Emiyasama/200kHz-/技术报告/8.10/加法器f.jpg

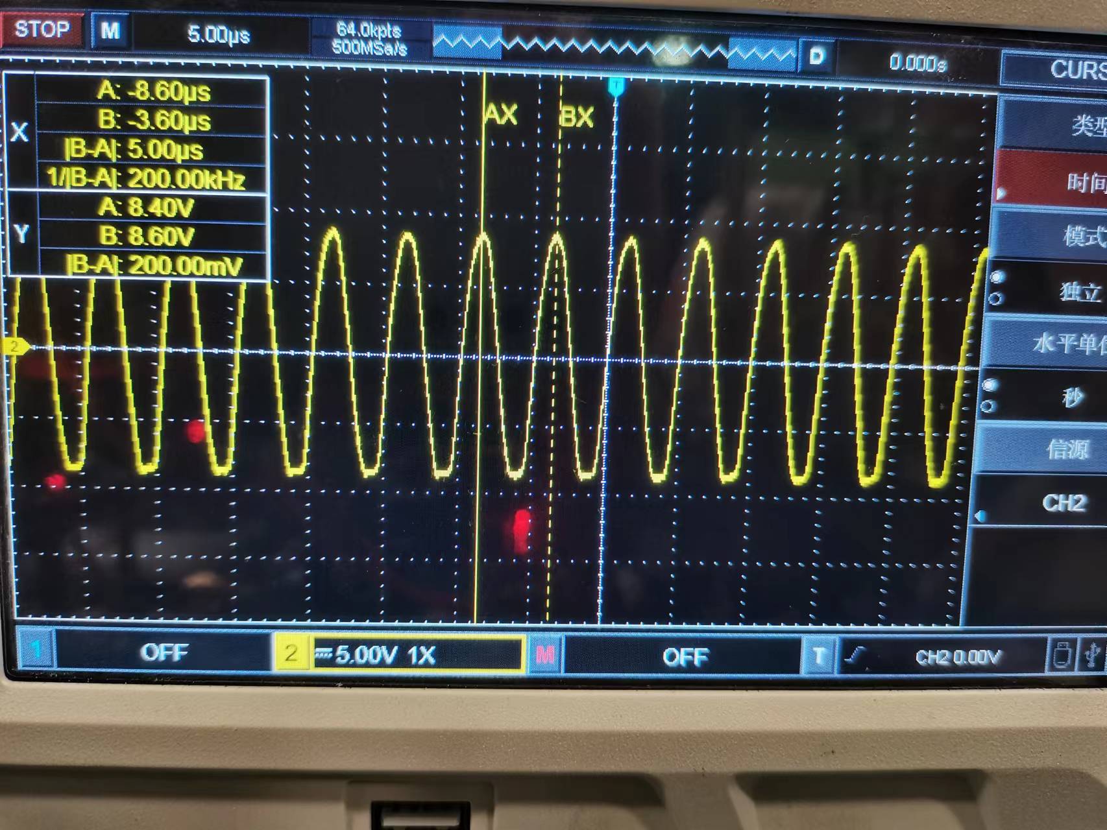
技术报告/8.10/加法器f.jpg
