Emiyasama/200kHz-/技术报告/8.10/JS放大v.jpg

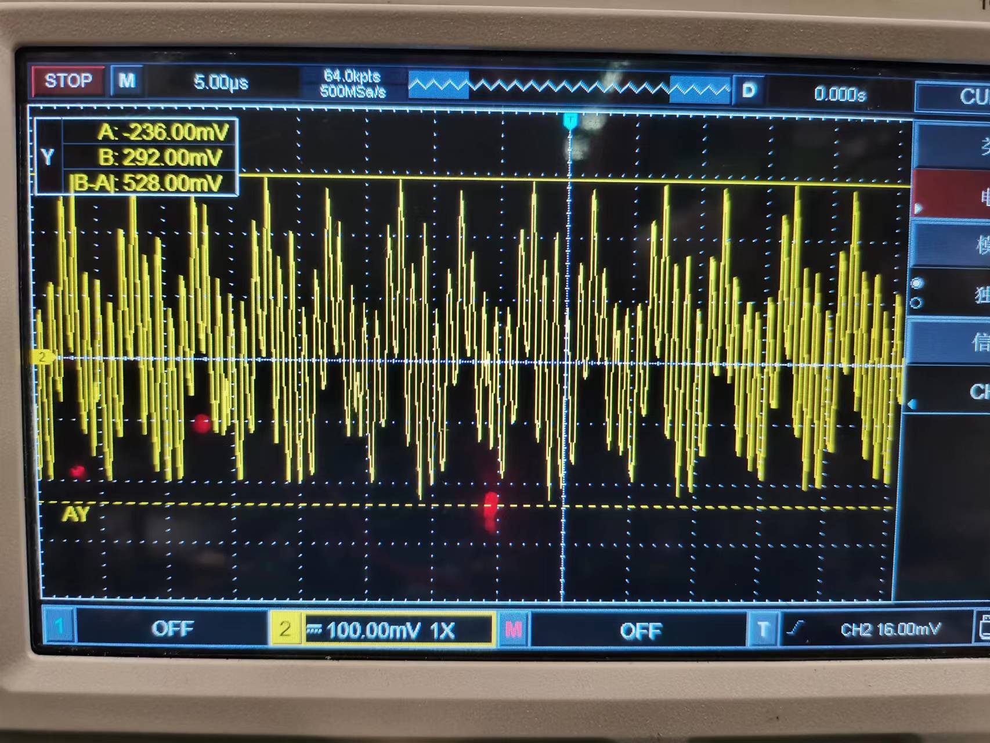
技术报告/8.10/JS放大v.jpg
