Emiyasama/200kHz-/完善部分/10.31实验测试.docx

# 10.31测试实验结果

1. 实验1

测试方法：2.8V直流手动开关

代码特点：增加GetCounter函数获取us级数据

测试结果：

测试结果分析：与手动计时大致相同

2. 实验2（1Hz）

测试方法：信号发生器不断发出1Hz方波

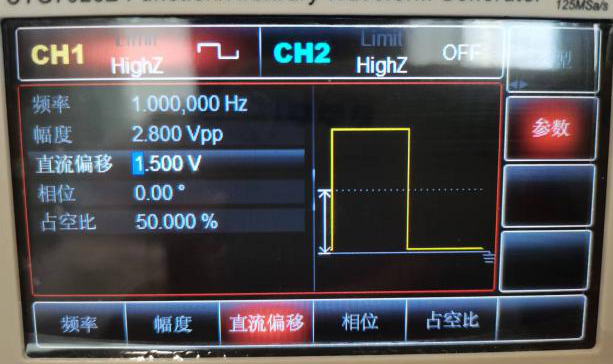
[picture p3: figure]
32578637da7344c97ca8820ba17ff3f
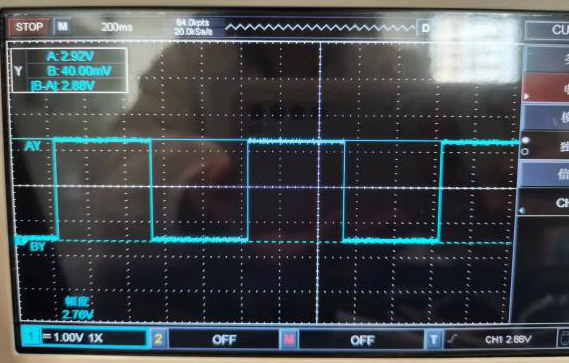
[picture p4: figure]
1dd68488990da3d1c9e9ab65cb5fa3e
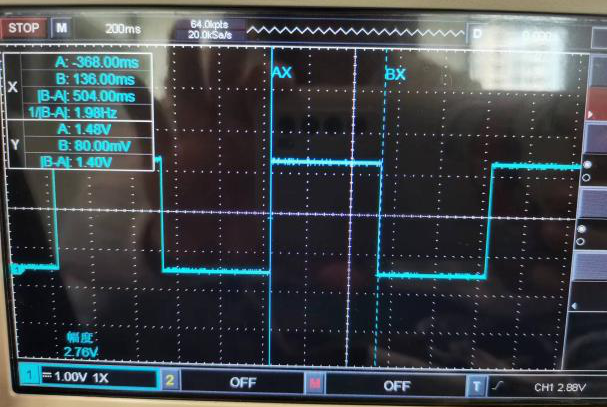
[picture p5: figure]
8cda7e7544e4407cf8b8d661fe90658

代码特点：不断检测波形为0的时间，直到检测第10次时延时暂停

测试结果：

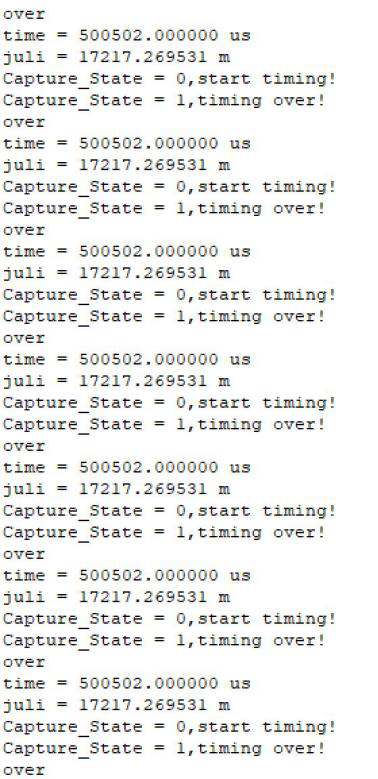
[picture p6: figure]
00c343ae68958e423938fa86a53dc3d
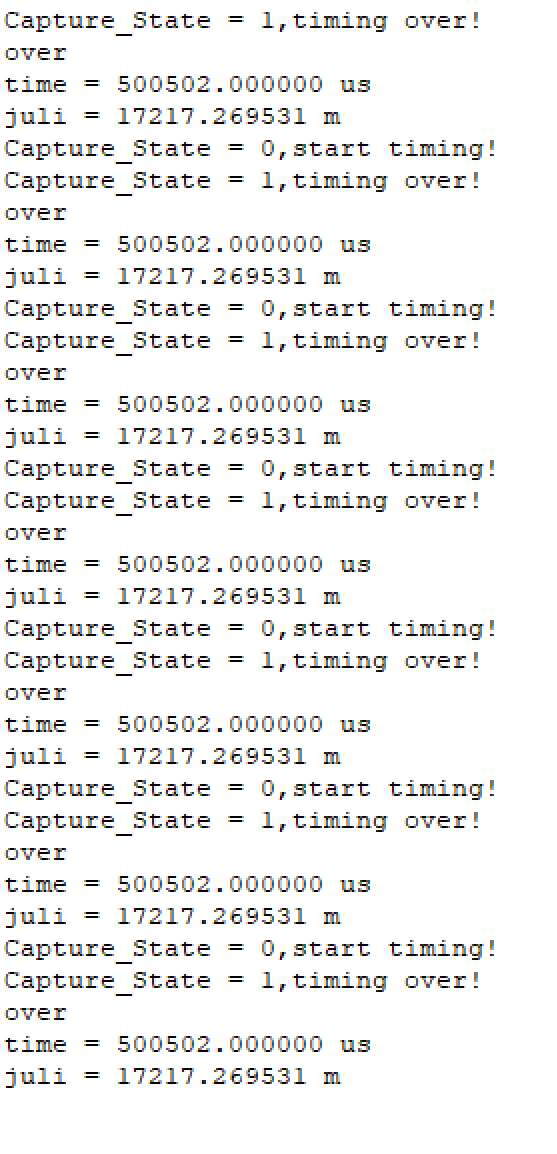
[picture p7: figure]
1231c2f782df83324b783fa7b925e0d

测试结果分析：

1Hz的波形测试结果准确，稳定为500.502ms，与示波器上显示的504ms有0.69%的误差

3. 实验3（10Hz）

测试方法：信号发生器不断发出10Hz方波

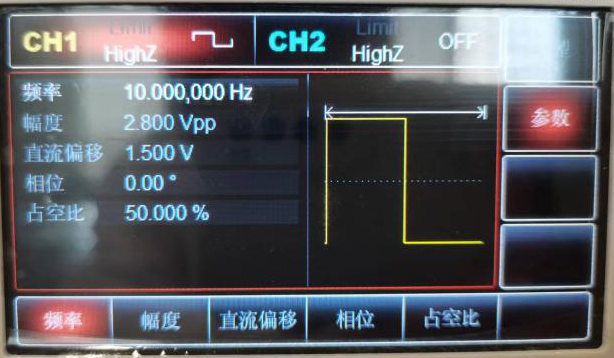
[picture p8: figure]
1635f2afd88267f08e8846b957ed129
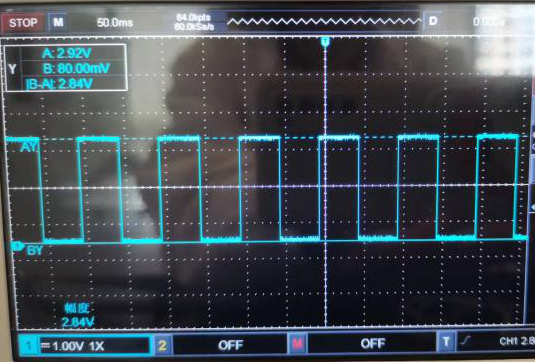
[picture p9: figure]
8b969923ffdeed18d06381cf51c97d7
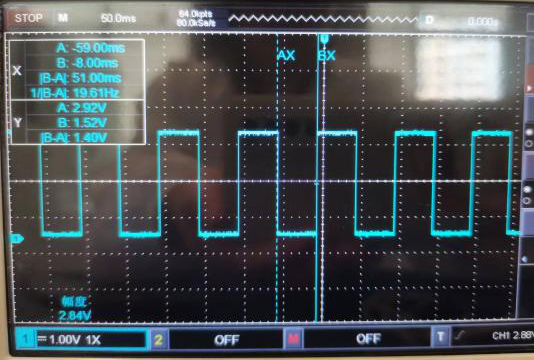
[picture p10: figure]
e0428f3fee62b50919884133da4d956

实验结果：

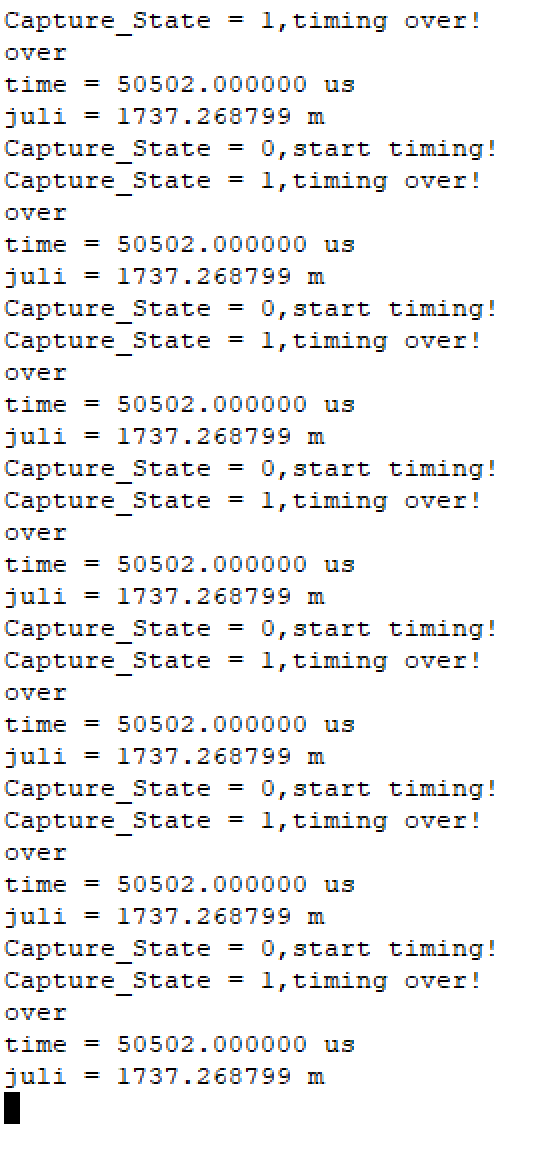
[picture p11: figure]
77cf63bb3595bb47136b22cc5ac2fc1

测试结果分析：测试结果稳定为50.502ms，与示波器上显示的51ms有0.97%的误差

4. 实验4（100Hz）

测试方法：信号发生器不断发出100Hz方波

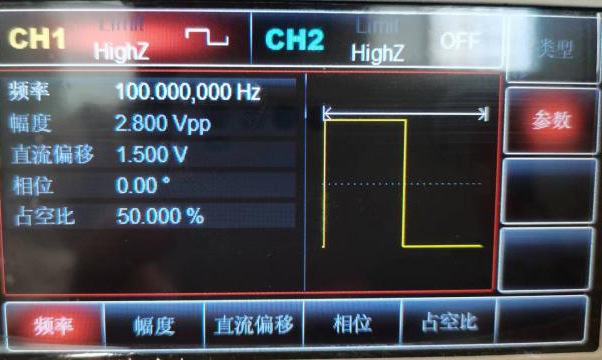
[picture p12: figure]
452ad50e35d795fb2d8274076c7eec2
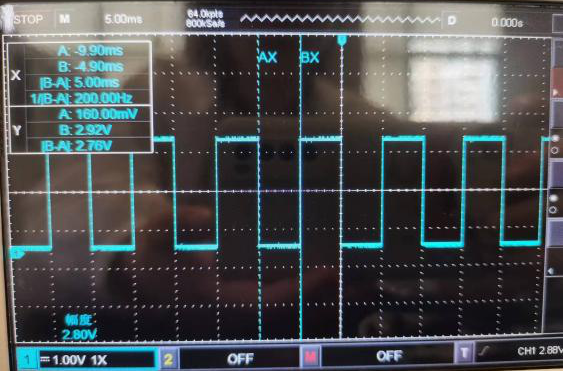
[picture p13: figure]
063b8be402b87d163d0b99ce19dfff6
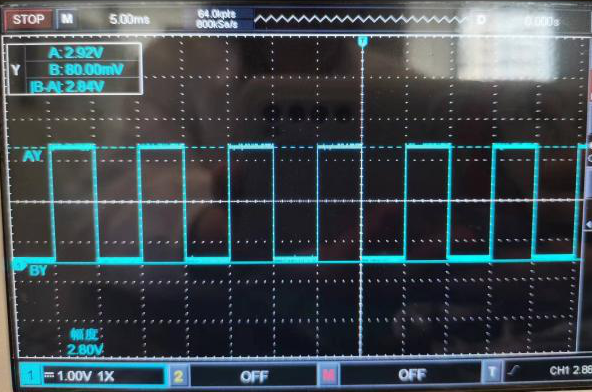
[picture p14: figure]
591af0bae8a63a09fa8aa62738394e4

实验结果：

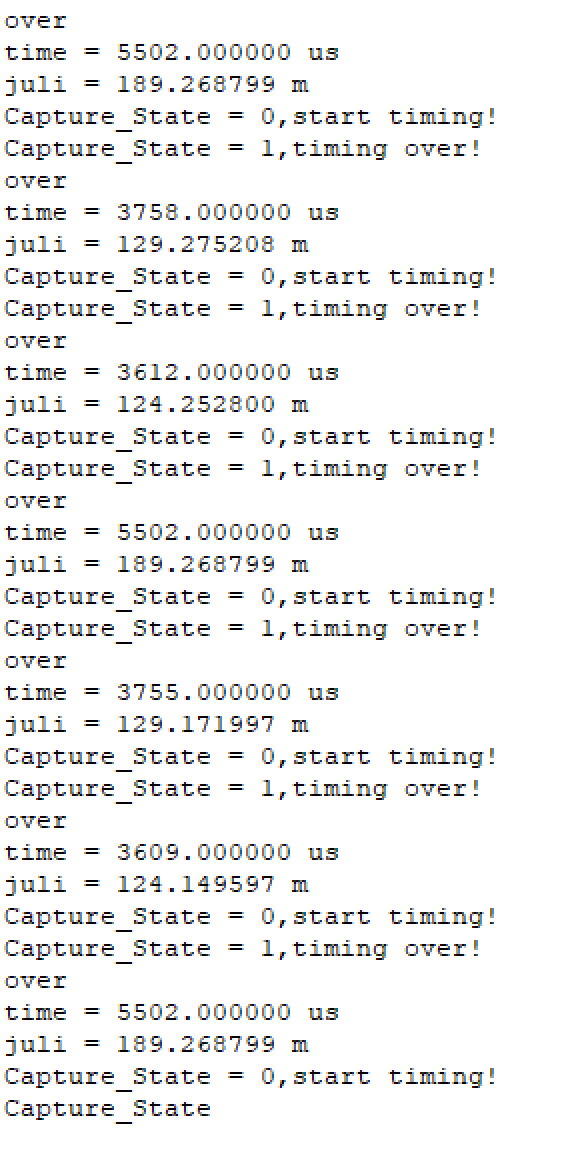
[picture p15: figure]
d63ea6d4f35196f89819aff3fc671ed

实验结果分析：100Hz时程序的运行速度就已经会影响到测量精度
