Emiyasama/200kHz-/技术报告/超声波测距测评展示.pptx

硬件

主控
STM32F103C8T6

软件

DDS发射波模块发波
&定时器开始计时

功放电路与加法器结合放大电压

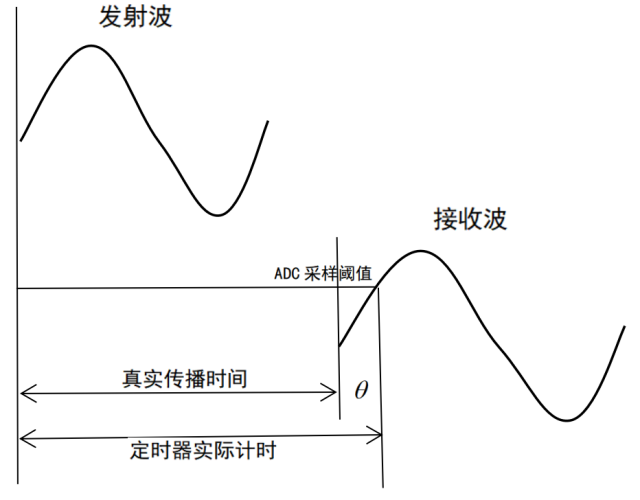
[picture p16: figure]
e5b2a22f83c2827bc41e58ca62ace3d

超声波换能器
发射端

超声波换能器接收端

功放电路放大约100倍

定时器停止计时&
fft算法计算相位差与传播时间

计算距离&关闭dds延时等待

ADC采样波形

OLED屏幕显示结果
