Emiyasama/200kHz-/完善部分/最小系统pcb板缺少元件.docx

# 新pcb板缺少元件汇总

编号 | 型号 | 类型名字 | 图片 | 数量 | 购买链接

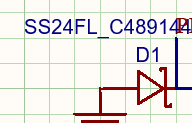
[picture p46: figure]

D1# | SS24FL_C489144 | 肖特基二极管 | | 1 | SS24肖特基二极管_SS24肖特基二极管采购信息-立创电子元器件商城 (szlcsc.com) (https://so.szlcsc.com/global.html?hot-key=LM358DR2G)

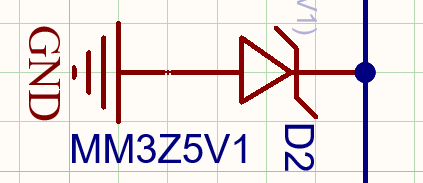
[picture p47: figure]

D2# | MM3Z5V1 | 稳压二极管 | | 1 | MM3Z5V1_MM3Z5V1采购信息-立创电子元器件商城 (szlcsc.com) (https://so.szlcsc.com/global.html?k=MM3Z5V1&hot-key=LM358DR2G)

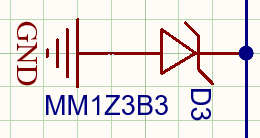
[picture p48: figure]

D3# | MM1Z3B3 | 稳压二极管 | | 1 | MM1Z3B3_MM1Z3B3采购信息-立创电子元器件商城 (szlcsc.com) (https://so.szlcsc.com/global.html?k=MM1Z3B3&hot-key=LM358DR2G)

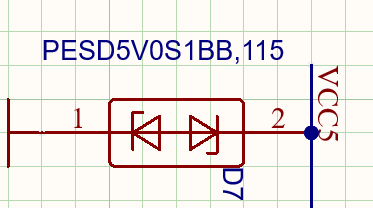
[picture p49: figure]

D7# | PESD5V0S1BB,115 | ESD保护二极管 | | 1 | PESD5V0S1BB,115_（Nexperia(安世)）PESD5V0S1BB,115中文资料_价格_PDF手册-立创电子商城 (szlcsc.com) (https://item.szlcsc.com/98848.html)

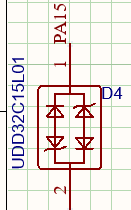
[picture p50: figure]

D4-D6,D8-D31,D33-D40# | UDD32C15L01 | ESD保护二极管 | | 35 | UDD32C05L01_（Brightking(君耀电子)）UDD32C05L01中文资料_价格_PDF手册-立创电子商城 (szlcsc.com) (https://item.szlcsc.com/79575.html)

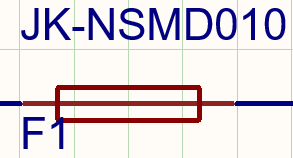
[picture p51: figure]

F1# | JK-NSMD010 | 保险电阻 | | 1 | JK-NSMD010_JK-NSMD010采购信息-立创电子元器件商城 (szlcsc.com) (https://so.szlcsc.com/global.html?k=JK-NSMD010&hot-key=LM358DR2G)

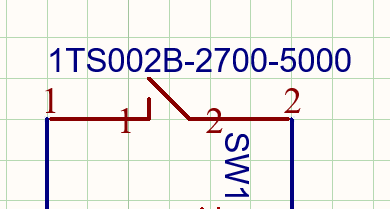
[picture p52: figure]

SW1# | 1TS002B-2700-5000 | 开关 | | 1 | 1TS002B-2700-5000-CT_（HYP(鸿源精密)）1TS002B-2700-5000-CT中文资料_价格_PDF手册-立创电子商城 (szlcsc.com) (https://item.szlcsc.com/300326.html)

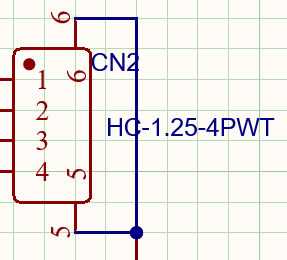
[picture p53: figure]

CN2# | HC-1.25-4PWT | 板对线连接器 | | 1 | HC-1.25-4PWT_（HCTL(华灿天禄)）HC-1.25-4PWT中文资料_价格_PDF手册-立创电子商城 (szlcsc.com) (https://item.szlcsc.com/3039062.html)
# | LM75A | 温度传感器
