Emiyasama/200kHz-/技术报告/2022年广东省大学生电子设计竞赛原创性声明(1)(1).docx

2022年广东省大学生电子设计竞赛

设计报告原创性声明

本人郑重声明：所呈交的设计报告是本人在指导老师的指导下独立进行研究/开发所取得的研究成果。除了报告中特别加以标注引用的内容外，本报告不包含任何其他个人或集体已经发表或撰写的作品成果。对本报告的研究做出重要贡献的个人和集体，均已在报告中以明确方式标明。本人完全意识到本声明的法律结果由本人承担。

作者签名：____________________________ 日期：______________
