Emiyasama/200kHz-/技术报告/2022年广东省大学生电子设计竞赛设计报告密封纸(1).docx

涂胶水区

涂胶水区

涂胶水区

[·订书针·]…………………设计报告密封纸1…………………[·订书针·]…………………设计报告密封纸1………………[·订书针·]
