Emiyasama/200kHz-/技术报告/设计报告书写规则.docx

书稿书写规则

第1篇 （一号黑体，单独占行，居中书写）

【一级标题】第1章 （单独占行，居中书写，小二号，幼圆加粗）

【示例】 A 题 双向 DC-DC 变换器

【二级标题】1.1 *** 或者 一、****（单独占行，退二字书写，小三 ，楷体）

【示例】一、任务

【三级标题】1.1.1 *** 或者（一）**** （单独占行，四号，黑体）

【四级标题】1.**** （单独占行，退二字书写，小四号 ，黑体）

【五级标题】（1）***。 （不独占行，退二字书写，五号字，宋体，后面加句号）

【六级标题】①******。 （不独占行，退二字书写，五号字，宋体，后面加句号）

作 品（黑体 三号，居中）

摘 要 （标宋 ，三号 居中）

说明：

正文： 全书五号宋体。

表：表头(黑体，小五号居中) ；表中文字 （宋体，小五号）

图： 图题 ，图注(宋体，小五号)，图中文字（宋体小五号，全书统一）。

表题、图题格式如下：表 章名-图序号， 图 章名-图序号

【示例】 表1-1 ****， 图1-1 *****。
