Emiyasama/200kHz-/赛题要求/关于2022年广东省大学生电子设计竞赛报名的通知.pdf

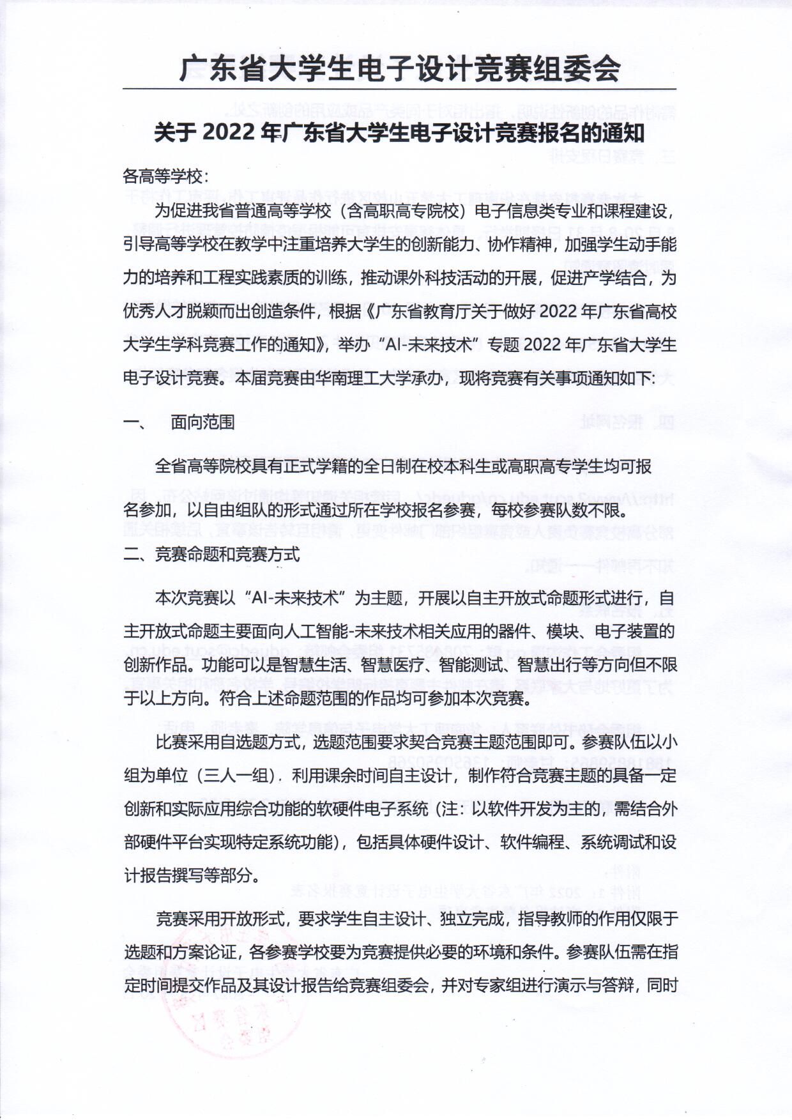
[picture p79: page 1]
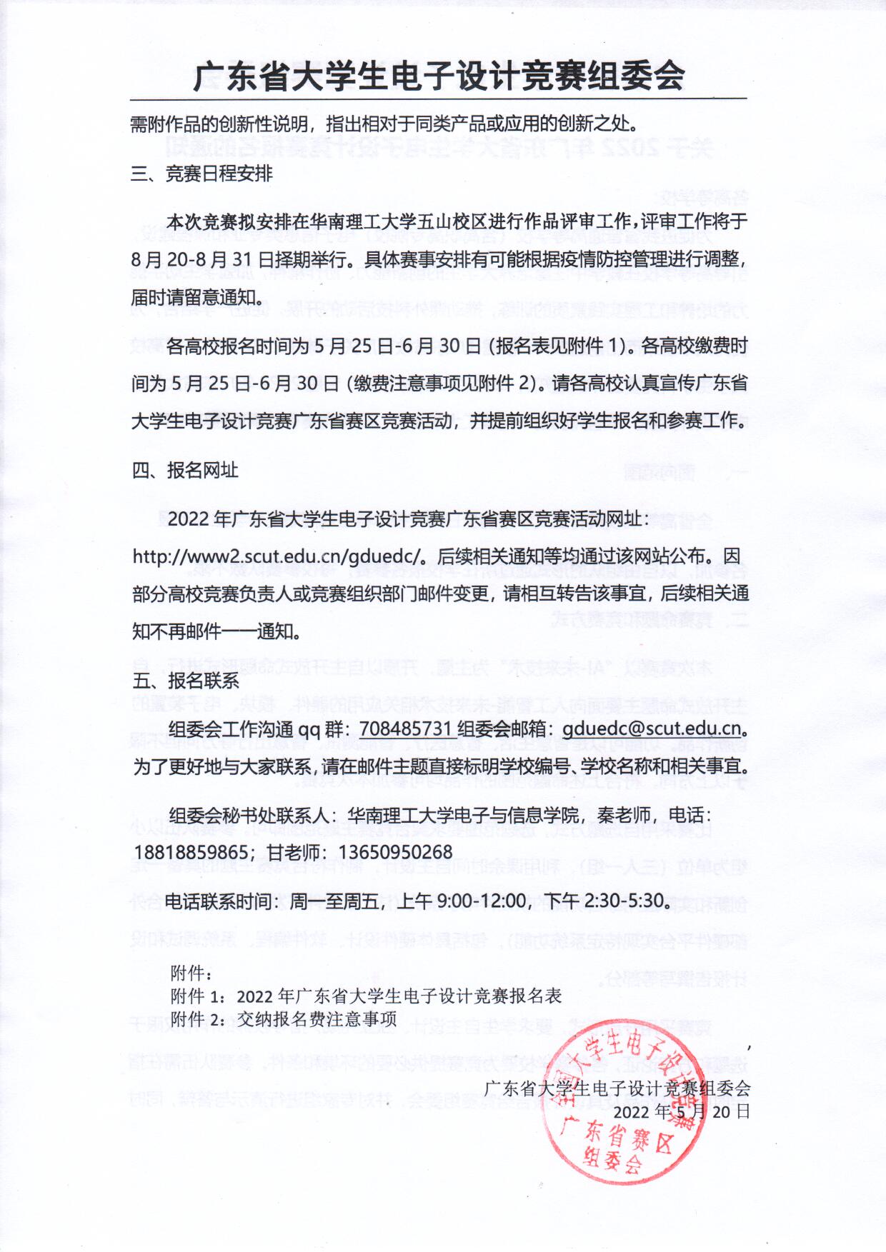
[picture p80: page 2]
