Emiyasama/200kHz-/11月22最新方案系统设计图.jpg

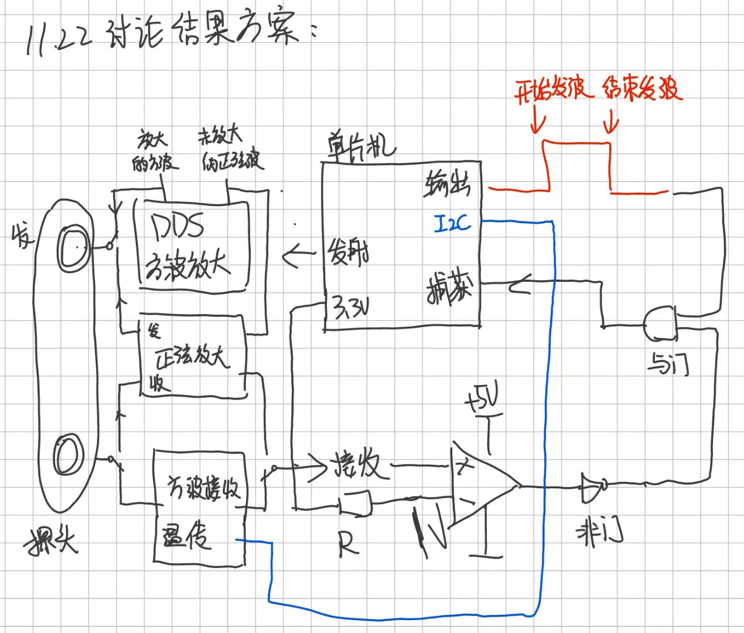
11月22最新方案系统设计图.jpg
