Emiyasama/200kHz-/参考文献/MC1496解调电路图.png

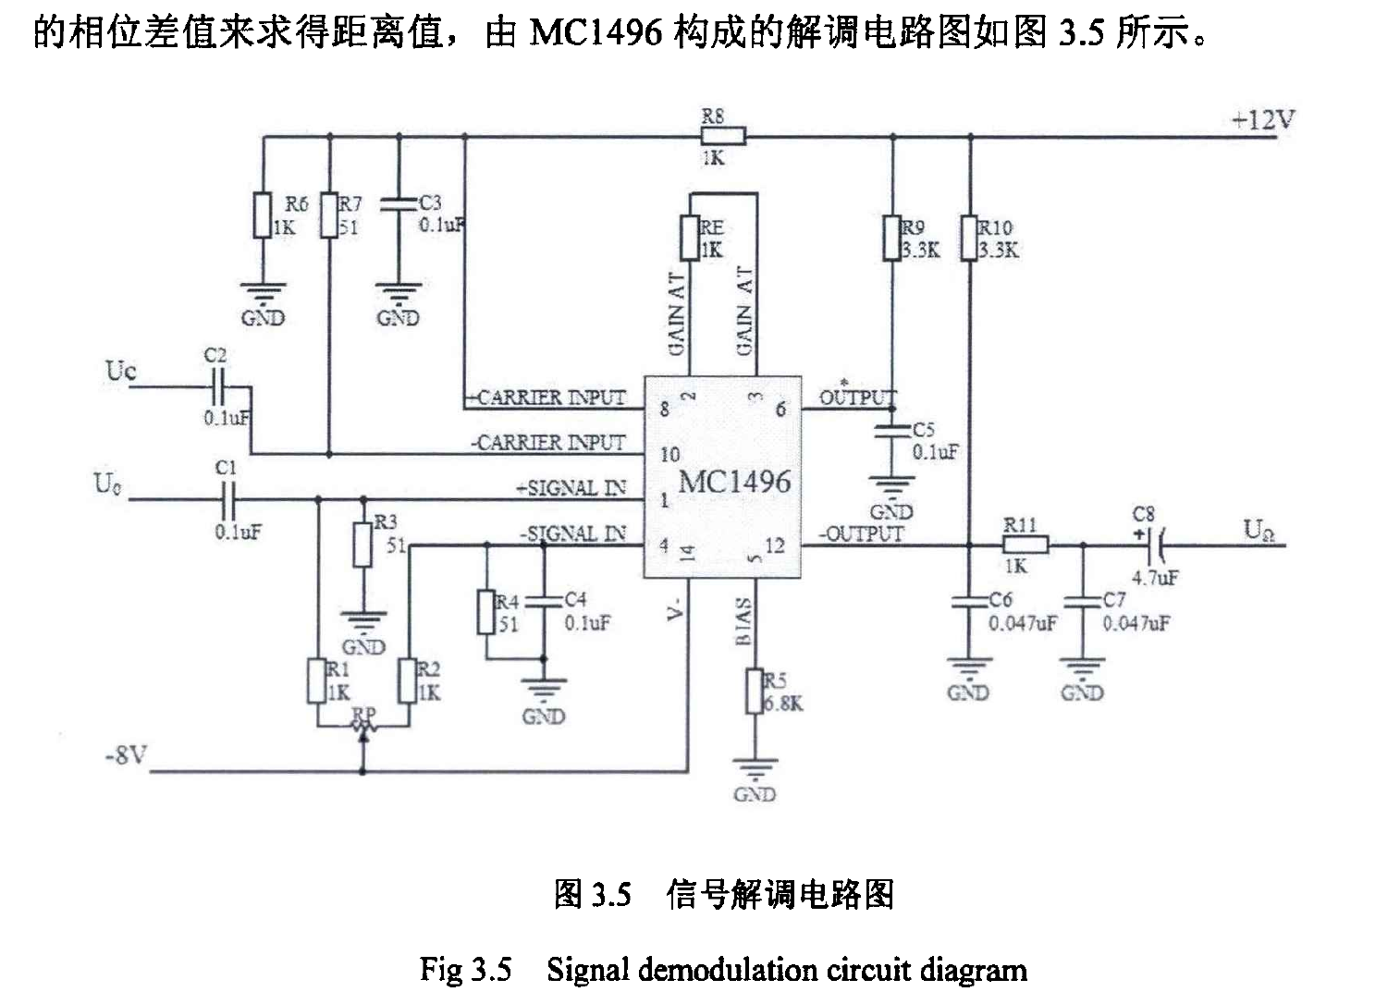
参考文献/MC1496解调电路图.png
