Emiyasama/200kHz-/参考文献/MC1496调幅电路.png

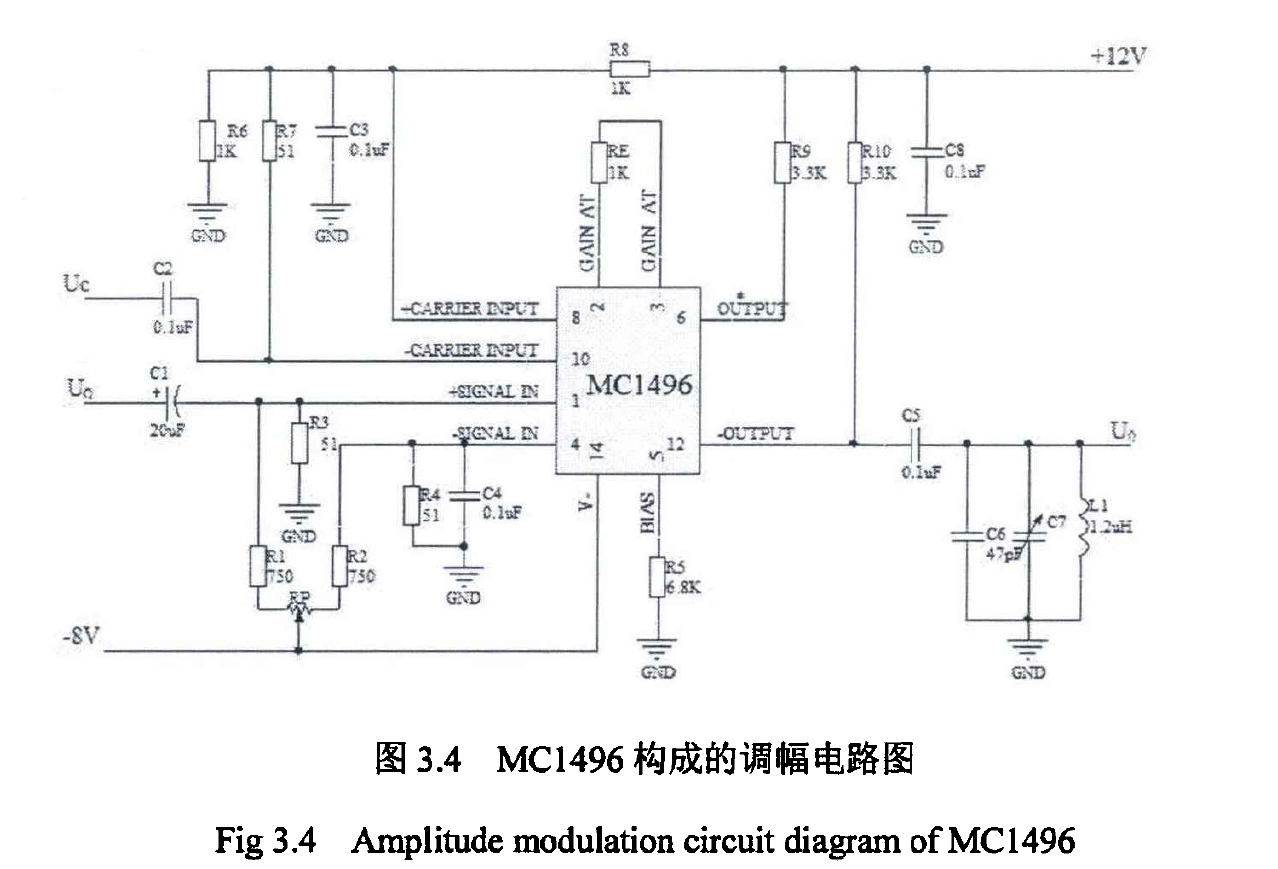
参考文献/MC1496调幅电路.png
