Emiyasama/200kHz-/参考文献/超声波发射电路.jpg

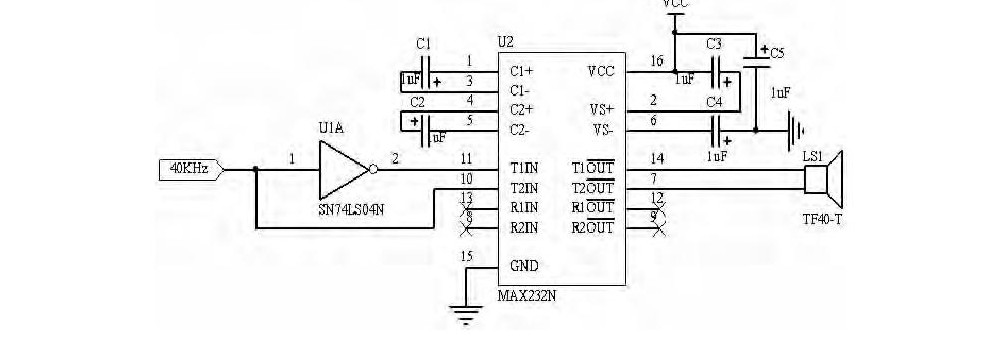
参考文献/超声波发射电路.jpg
