Emiyasama/200kHz-/参考文献/超声波接收电路.jpg

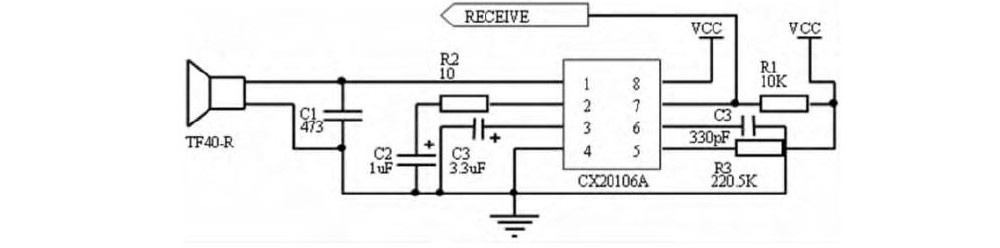
参考文献/超声波接收电路.jpg
