Emiyasama/200kHz-/参考文献/集成模拟乘法器MC1496.png

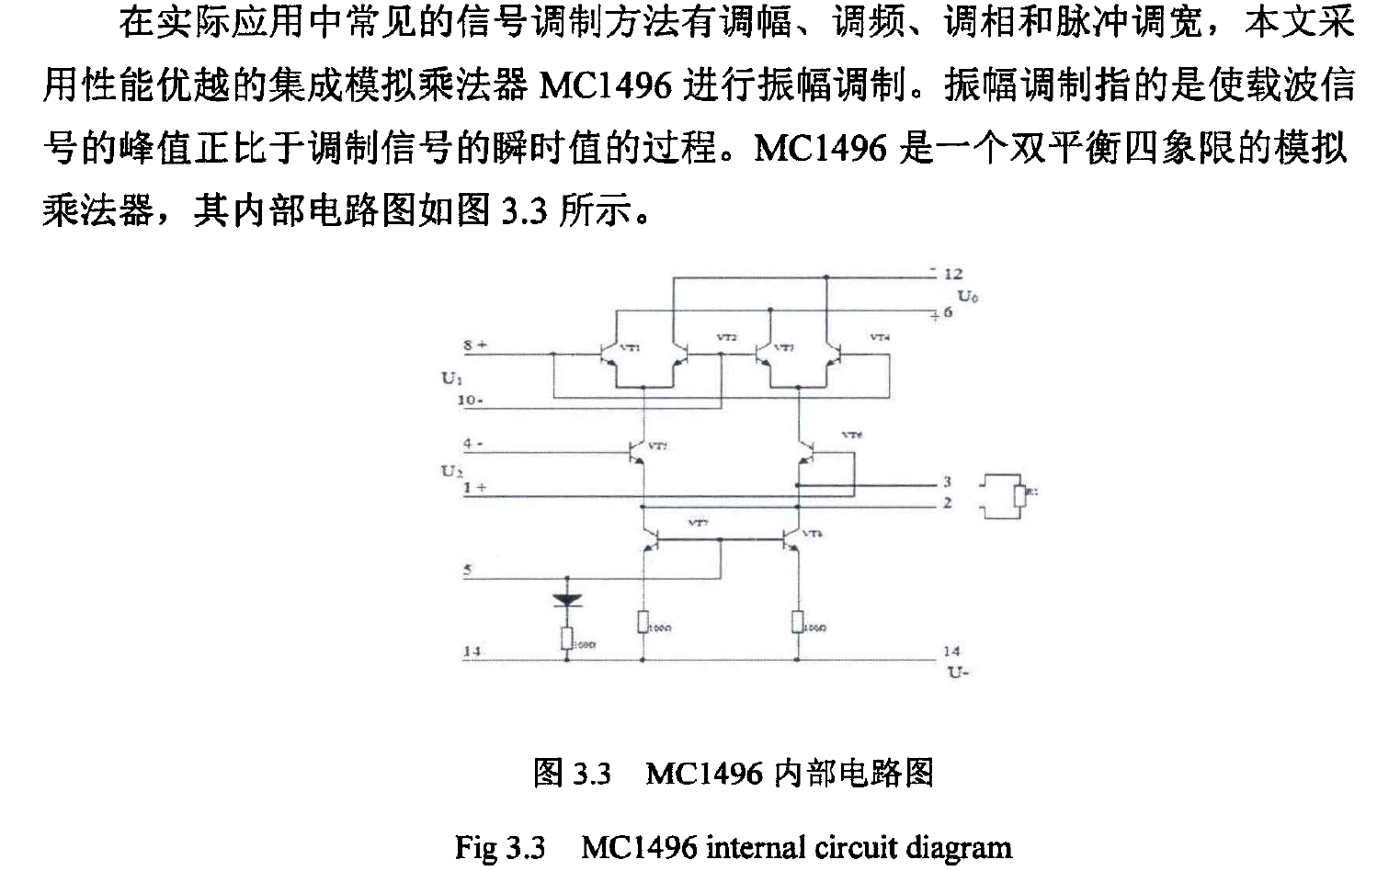
参考文献/集成模拟乘法器MC1496.png
