Emiyasama/200kHz-/技术报告/7-OLED屏与温度传感器.png

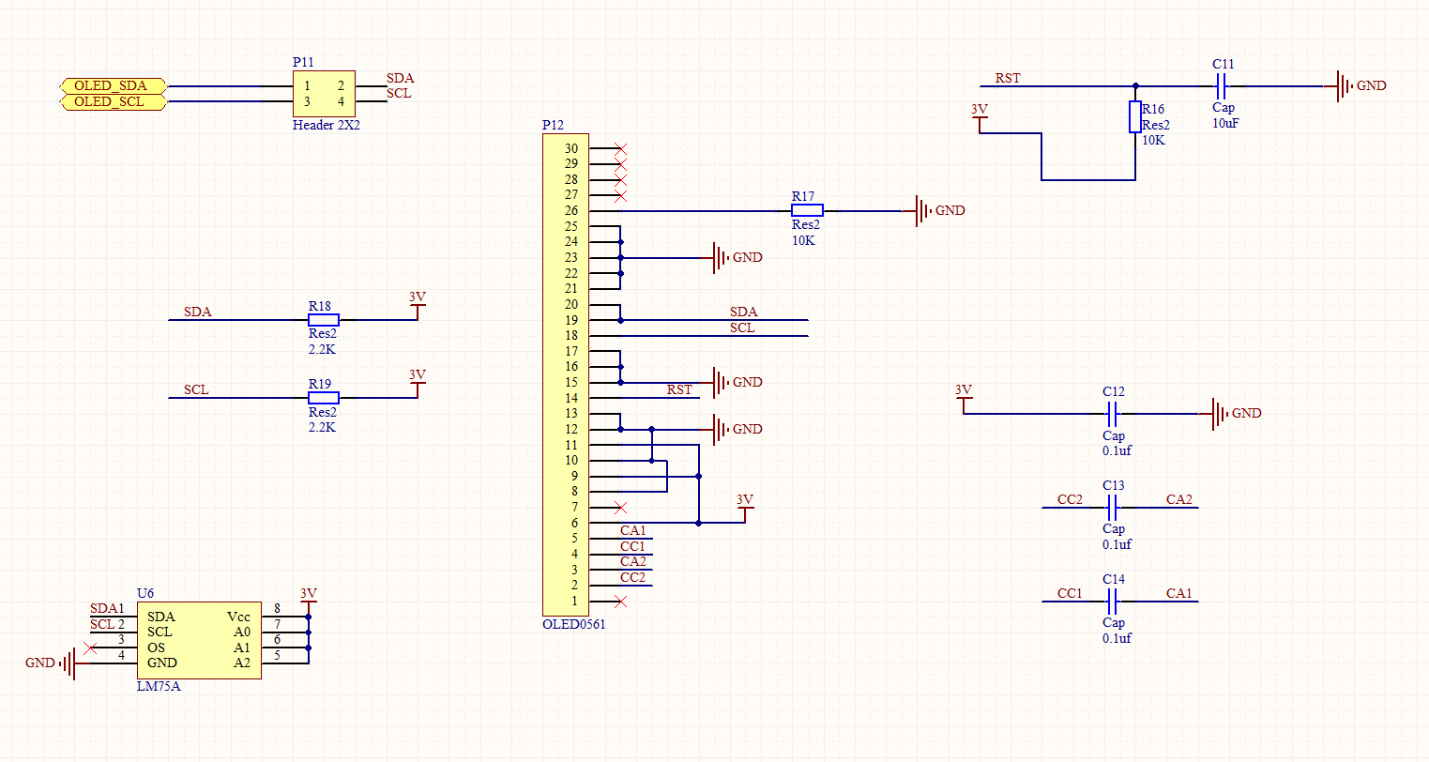
技术报告/7-OLED屏与温度传感器.png
