Emiyasama/200kHz-/技术报告/8.10/0.05mm.jpg

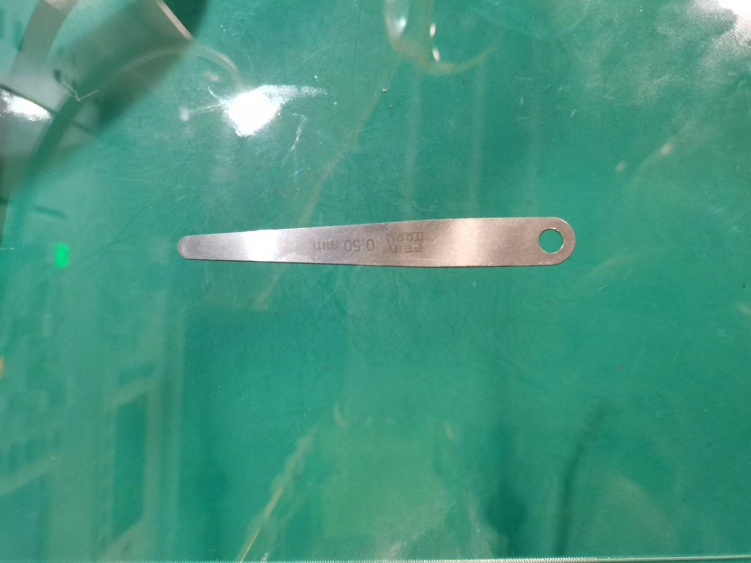
技术报告/8.10/0.05mm.jpg
