Emiyasama/200kHz-/技术报告/8.10/1mm放置.jpg

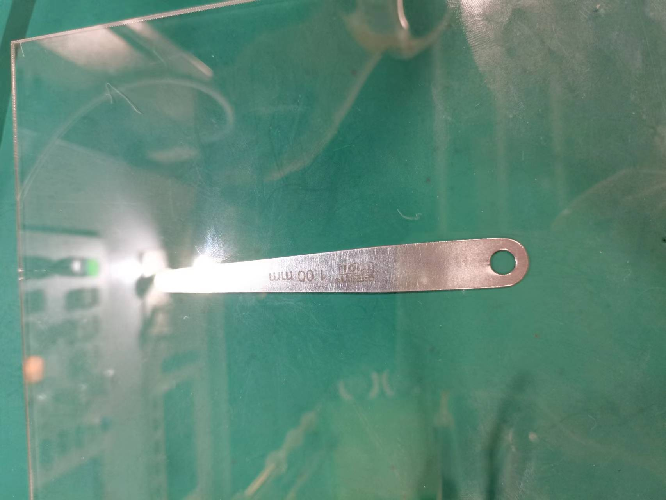
技术报告/8.10/1mm放置.jpg
