Emiyasama/200kHz-/技术报告/8.10/2mm展示.jpg

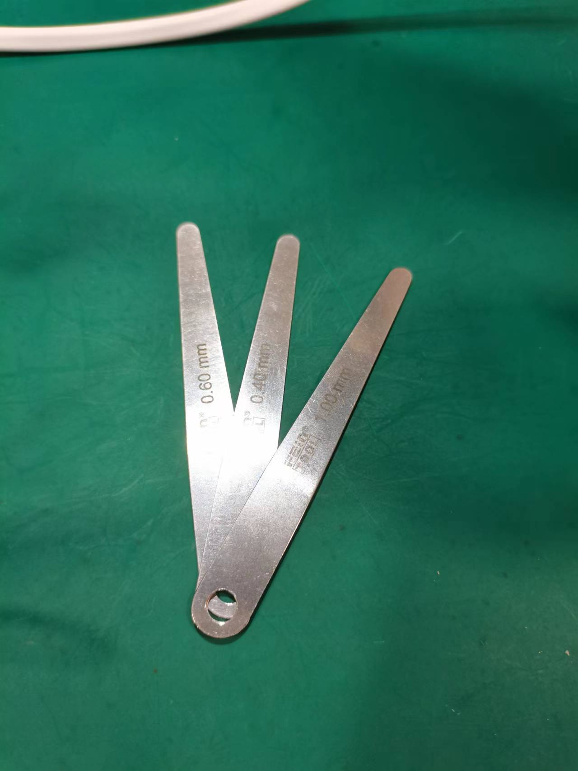
技术报告/8.10/2mm展示.jpg
