Emiyasama/200kHz-/技术报告/8.10/2mm结果（17.83）.jpg

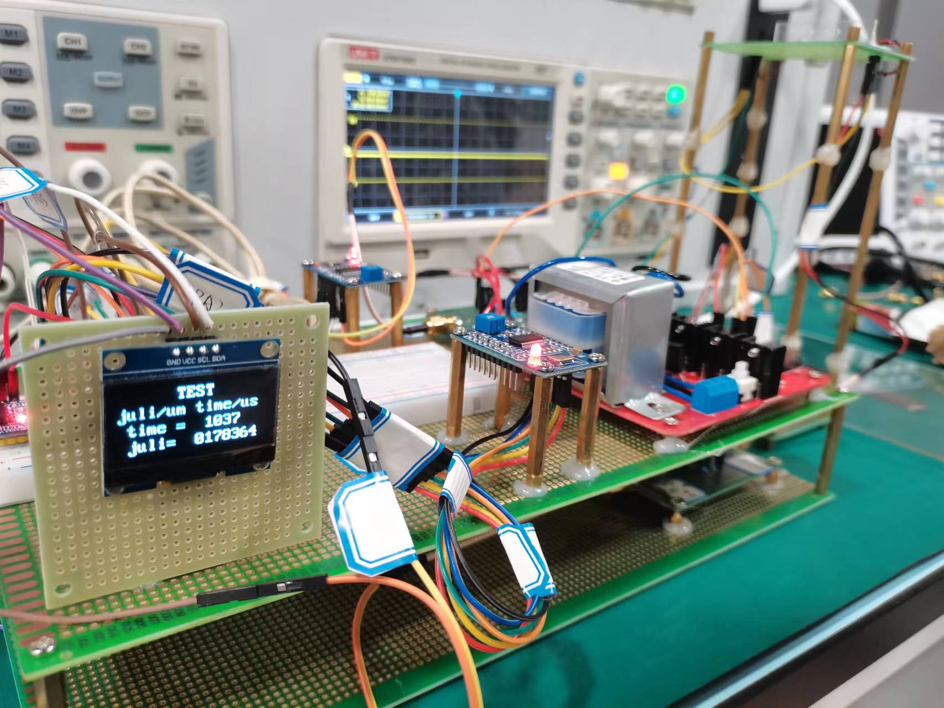
技术报告/8.10/2mm结果（17.83）.jpg
