Emiyasama/200kHz-/技术报告/8.10/3mm展示2.jpg

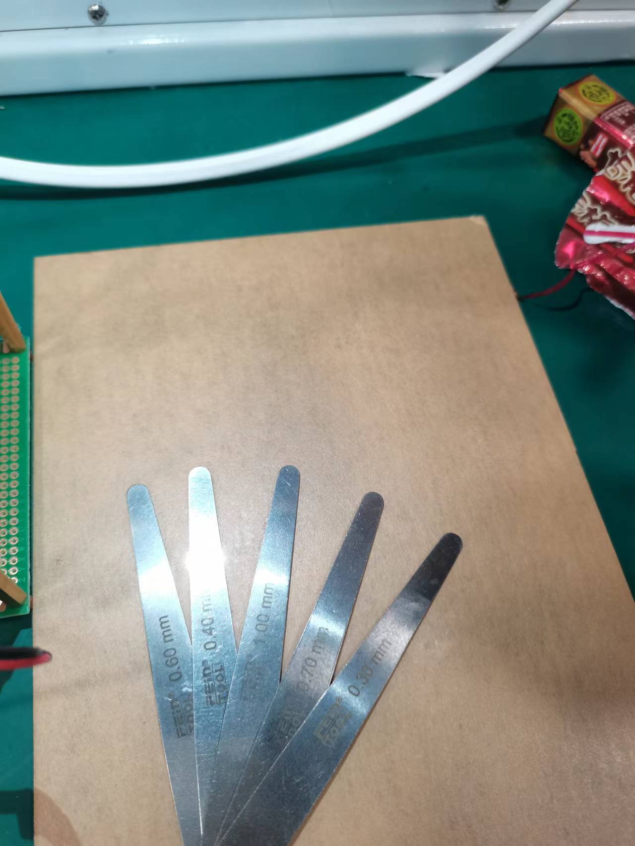
技术报告/8.10/3mm展示2.jpg
