Emiyasama/200kHz-/技术报告/8.10/3mm展示.jpg

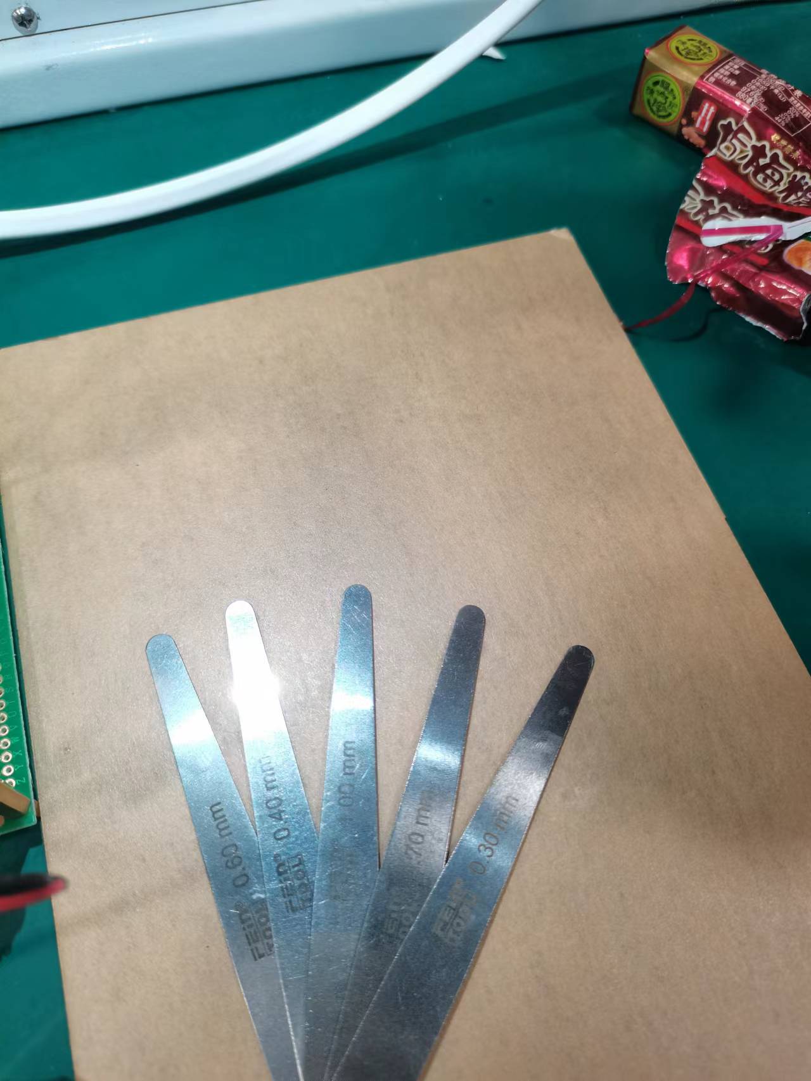
技术报告/8.10/3mm展示.jpg
