Emiyasama/200kHz-/技术报告/8.10/3mm放置.jpg

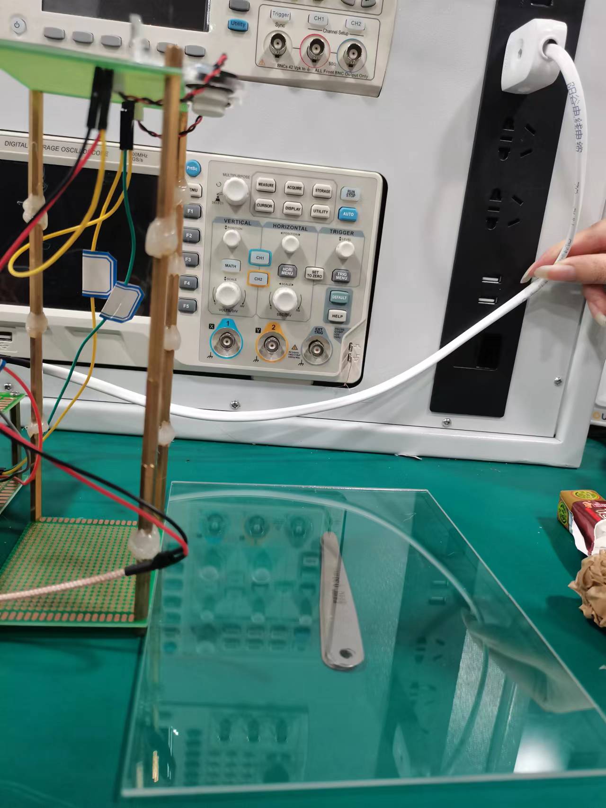
技术报告/8.10/3mm放置.jpg
