Emiyasama/200kHz-/技术报告/8.10/下层.jpg

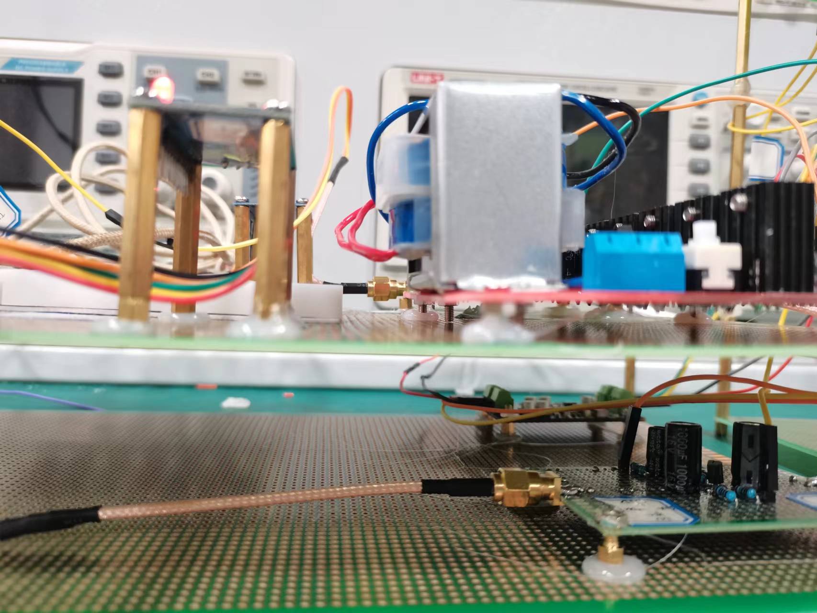
技术报告/8.10/下层.jpg
