Emiyasama/200kHz-/技术报告/8.10/俯拍装置全景.jpg

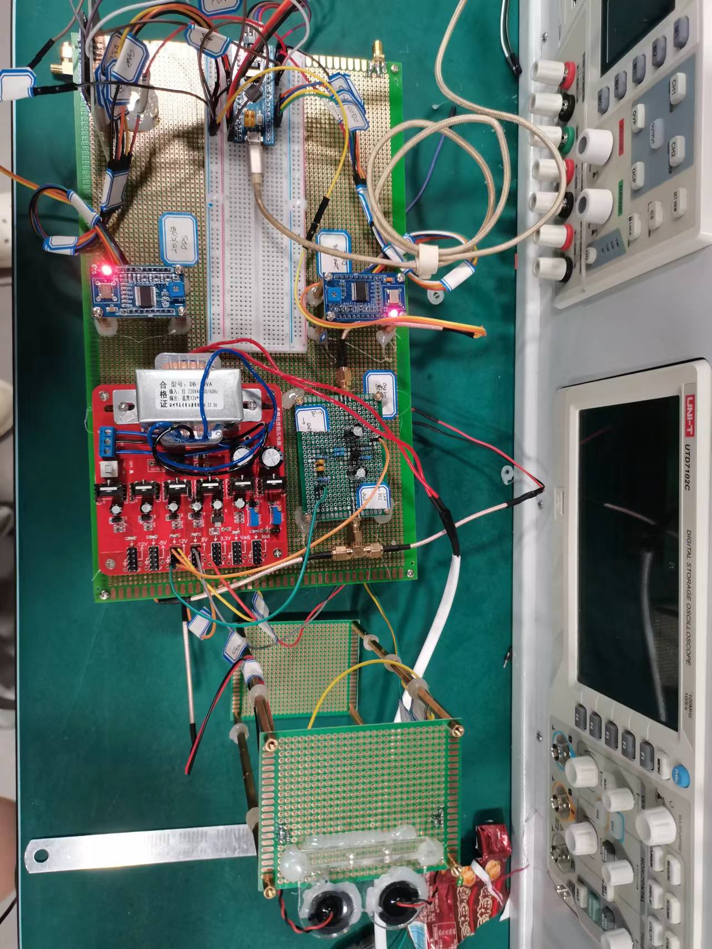
技术报告/8.10/俯拍装置全景.jpg
