Emiyasama/200kHz-/技术报告/8.10/初始高度18.15cm.jpg

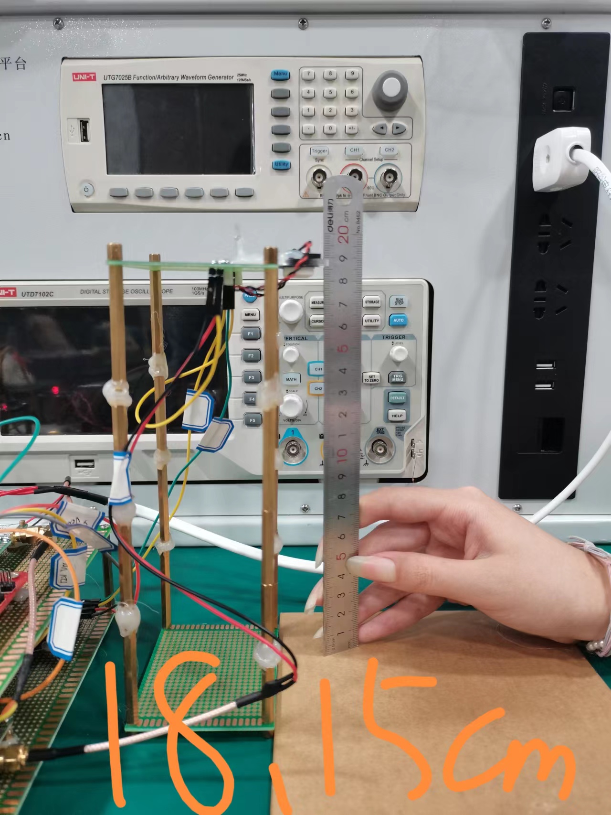
技术报告/8.10/初始高度18.15cm.jpg
