Emiyasama/200kHz-/技术报告/8.10/初始高度装置测量结果.jpg

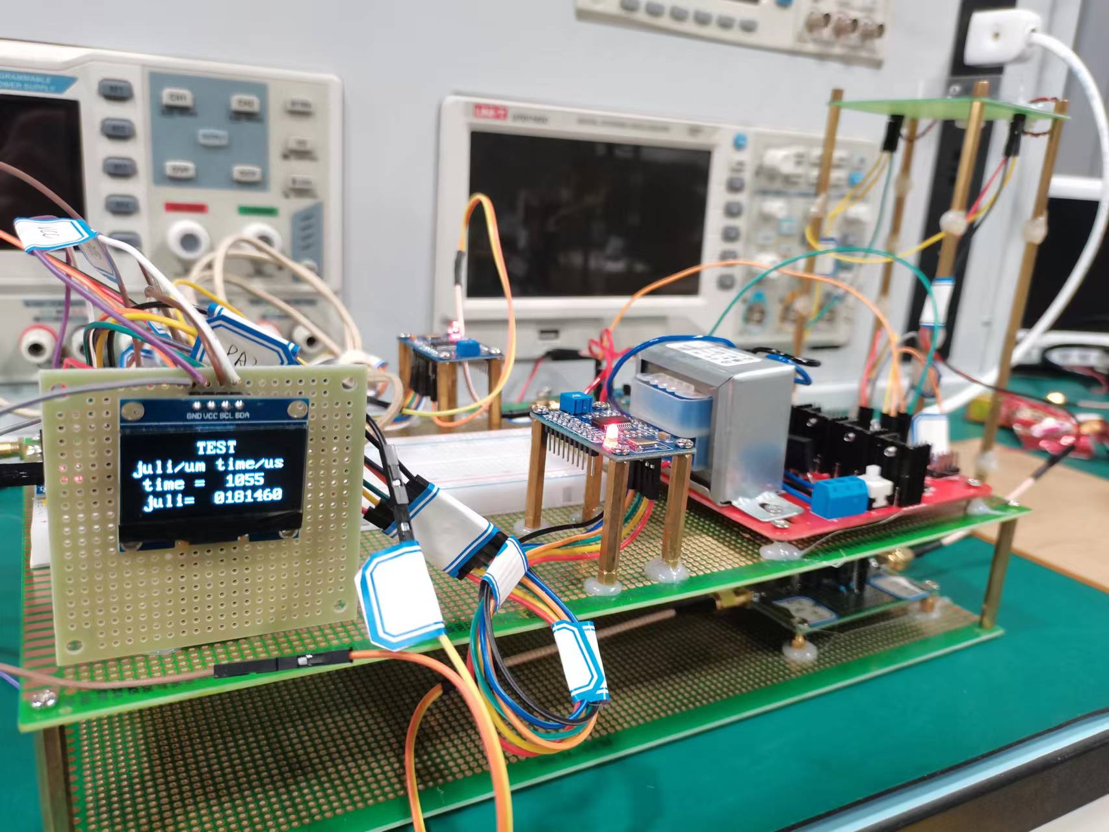
技术报告/8.10/初始高度装置测量结果.jpg
