Emiyasama/200kHz-/技术报告/8.10/探头高度2.jpg

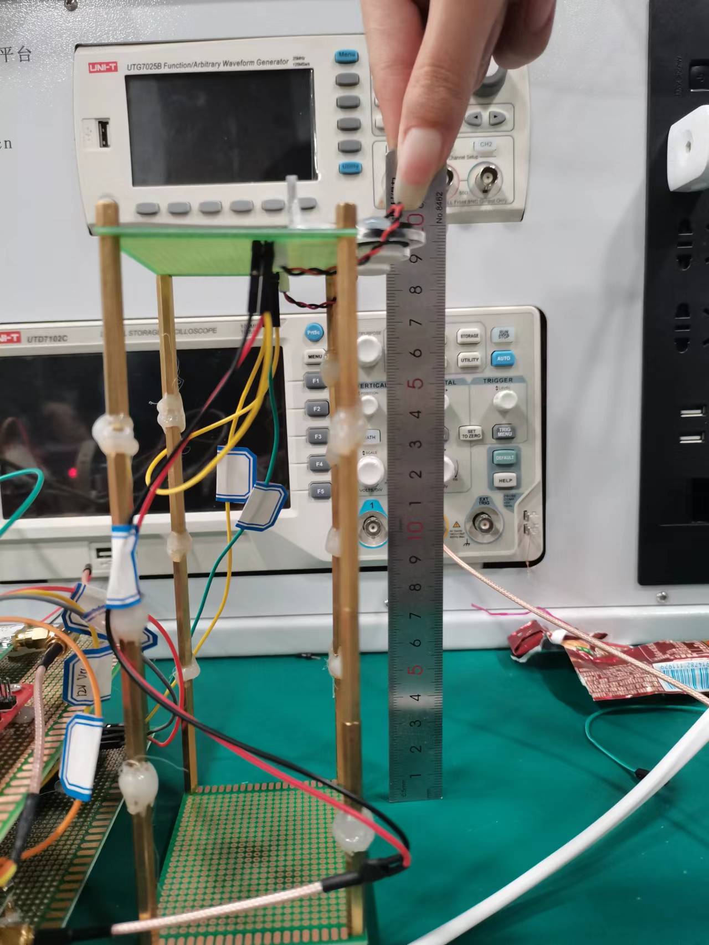
技术报告/8.10/探头高度2.jpg
