Emiyasama/200kHz-/技术报告/8.10/结果18.0428.jpg

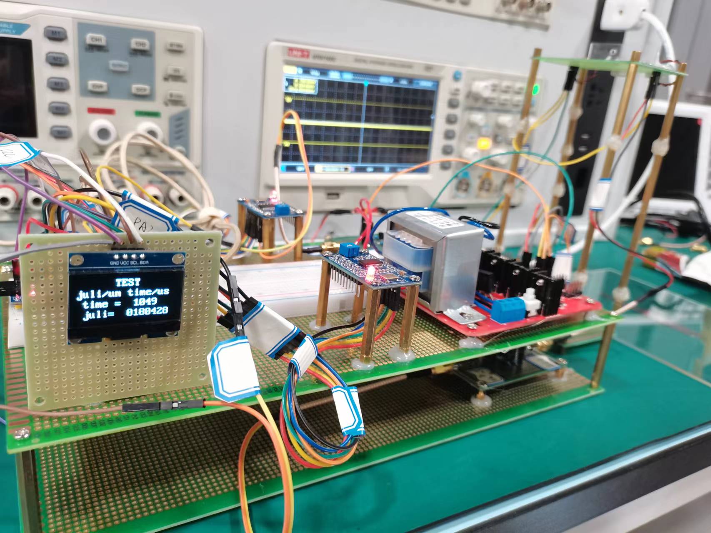
技术报告/8.10/结果18.0428.jpg
