Emiyasama/200kHz-/技术报告/8.10/结果(17.93).jpg

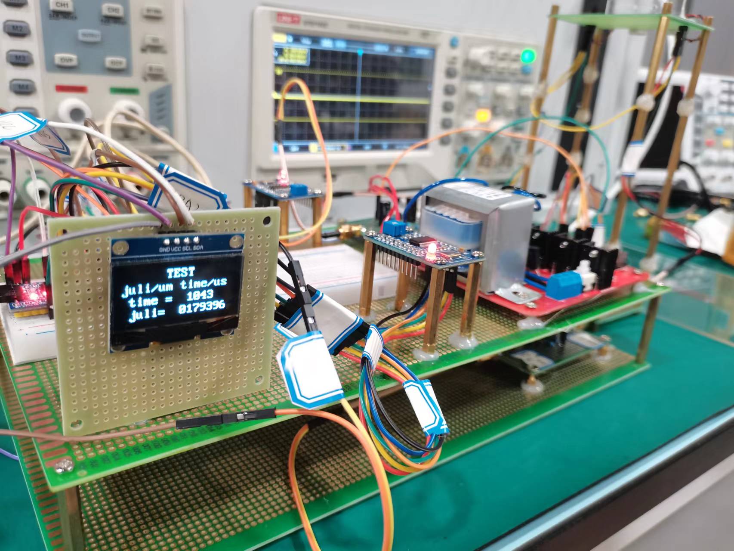
技术报告/8.10/结果(17.93).jpg
