Emiyasama/200kHz-/技术报告/200kdds电压.jpg

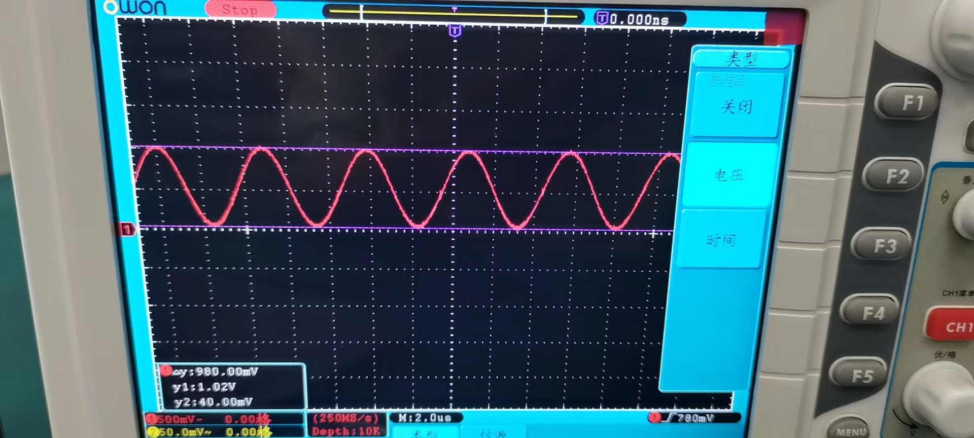
技术报告/200kdds电压.jpg
