Emiyasama/200kHz-/技术报告/200k电压周期.jpg

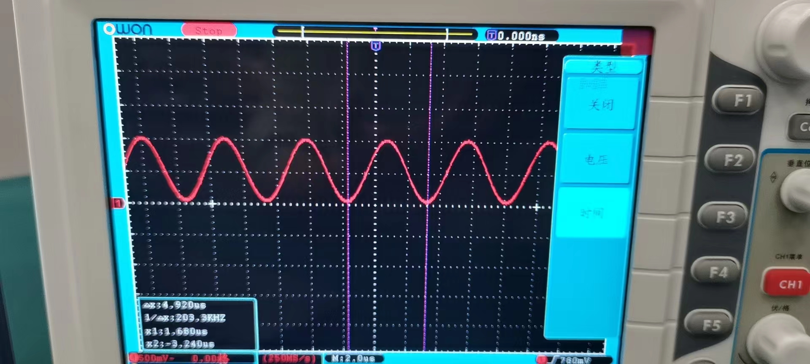
技术报告/200k电压周期.jpg
