Emiyasama/200kHz-/技术报告/ADC采集图.png

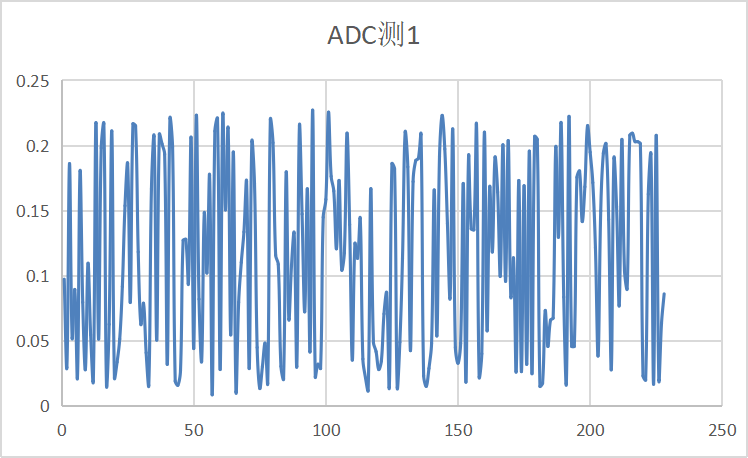
技术报告/ADC采集图.png
