Emiyasama/200kHz-/技术报告/发射电路框图.png

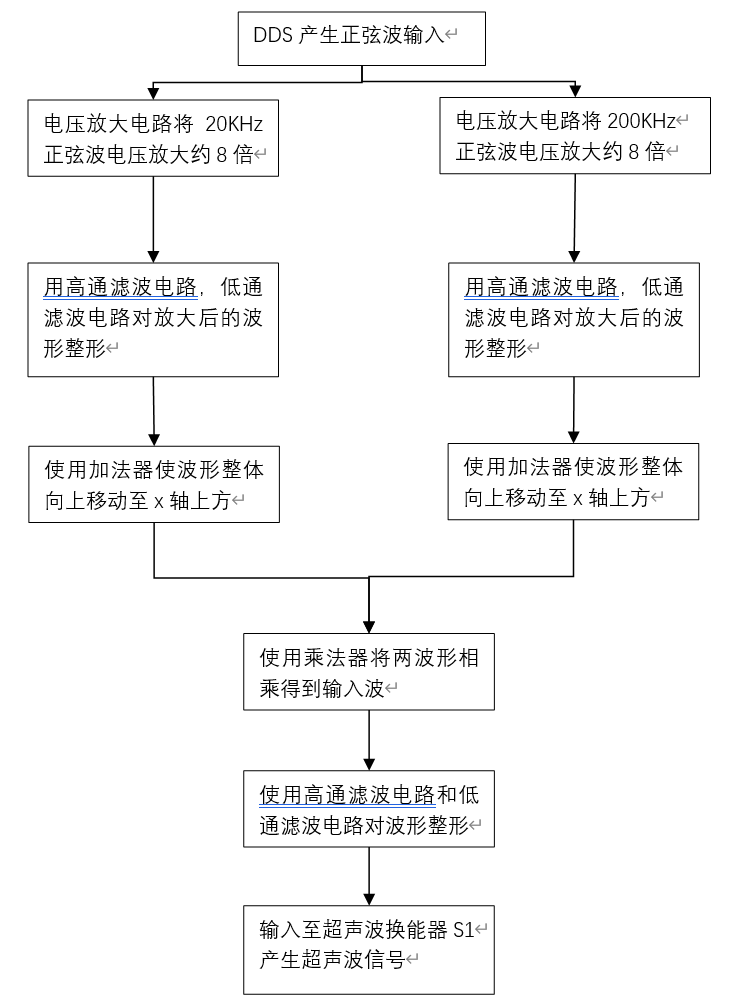
技术报告/发射电路框图.png
