Emiyasama/200kHz-/技术报告/废稿/调制mtalab仿真.png

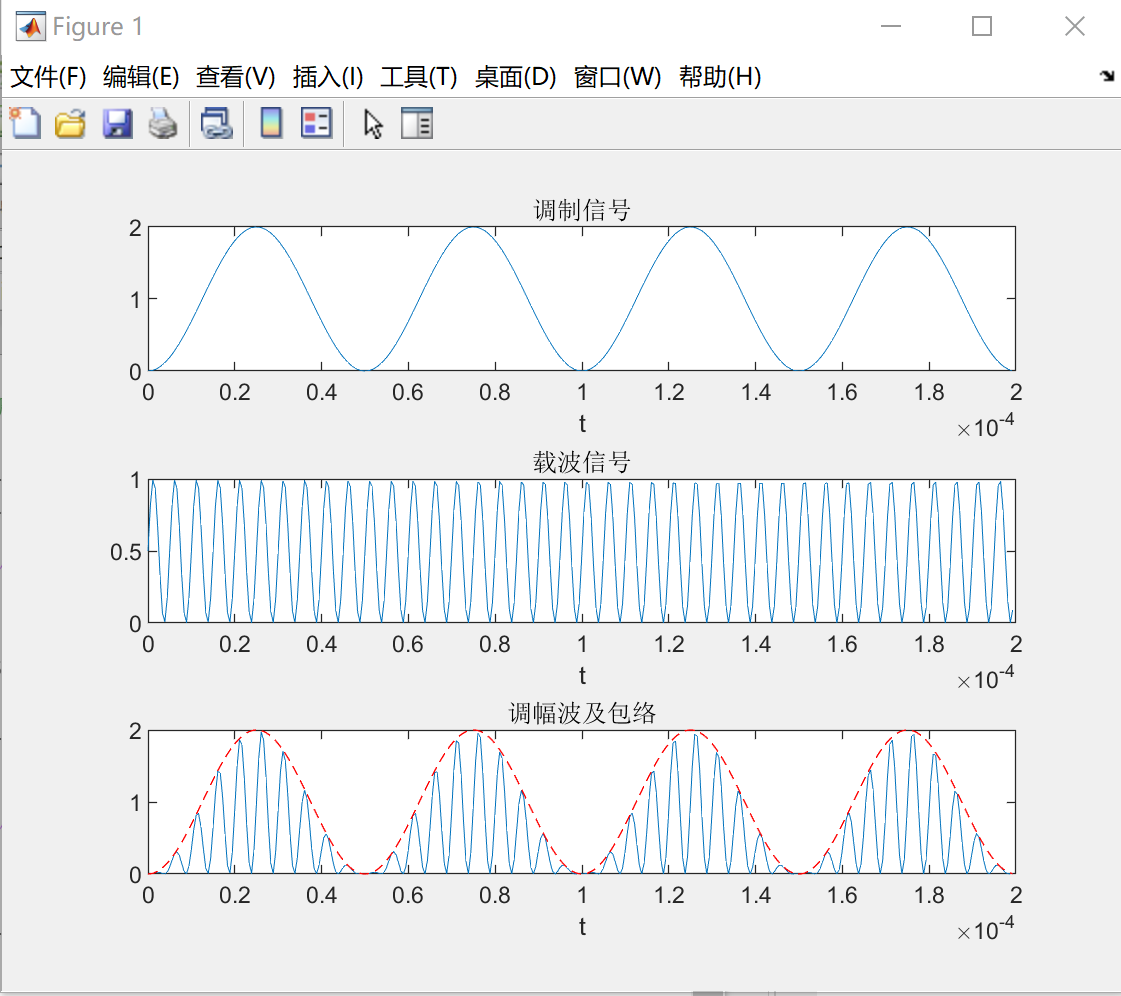
技术报告/废稿/调制mtalab仿真.png
