Emiyasama/200kHz-/技术报告/废稿/项目框图.png

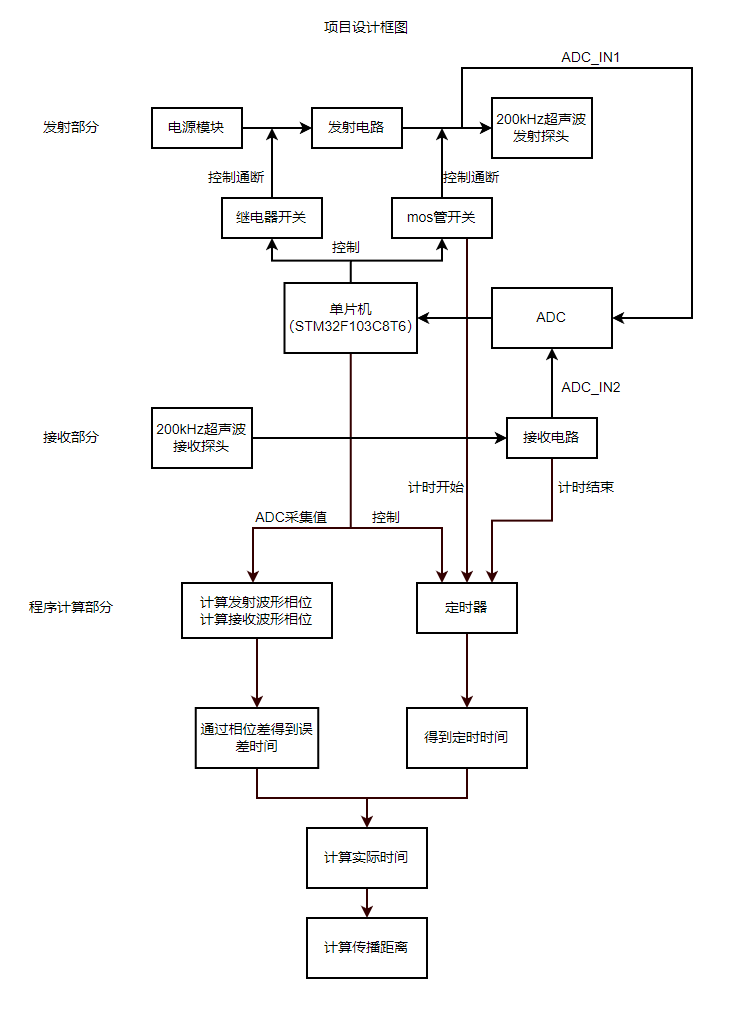
技术报告/废稿/项目框图.png
