Emiyasama/200kHz-/技术报告/系统框图.png

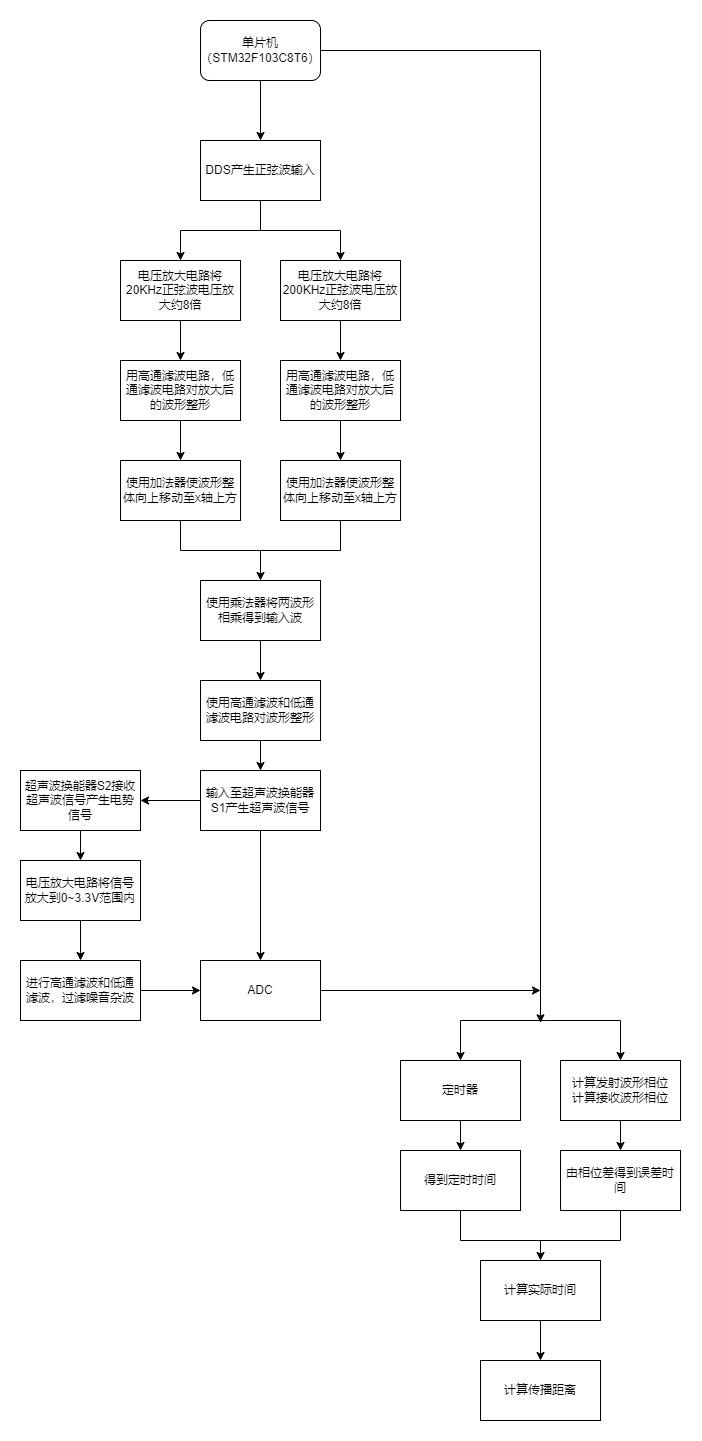
技术报告/系统框图.png
