Emiyasama/200kHz-/技术报告/解调仿真.jpg

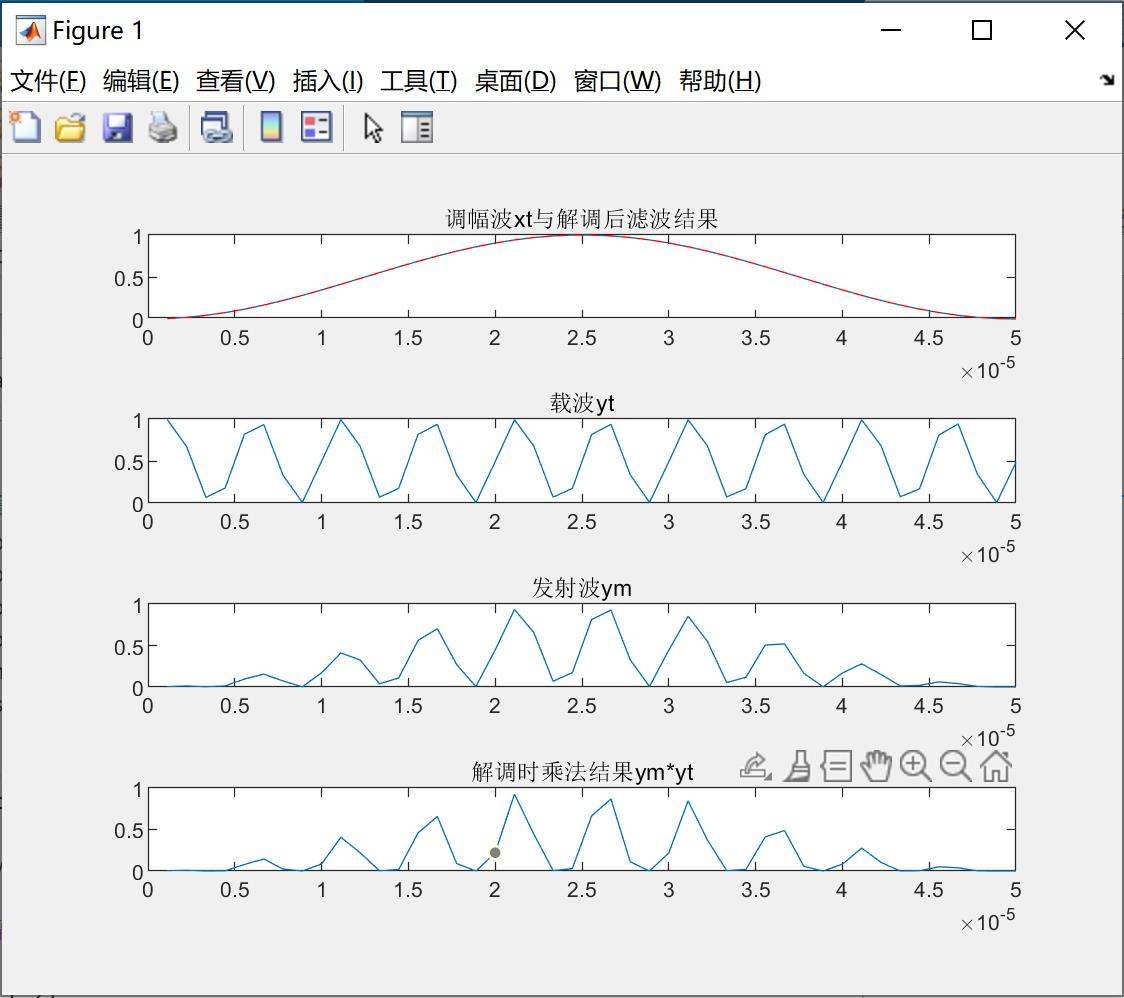
技术报告/解调仿真.jpg
