Emiyasama/200kHz-/技术报告/调制0-1v仿真.png

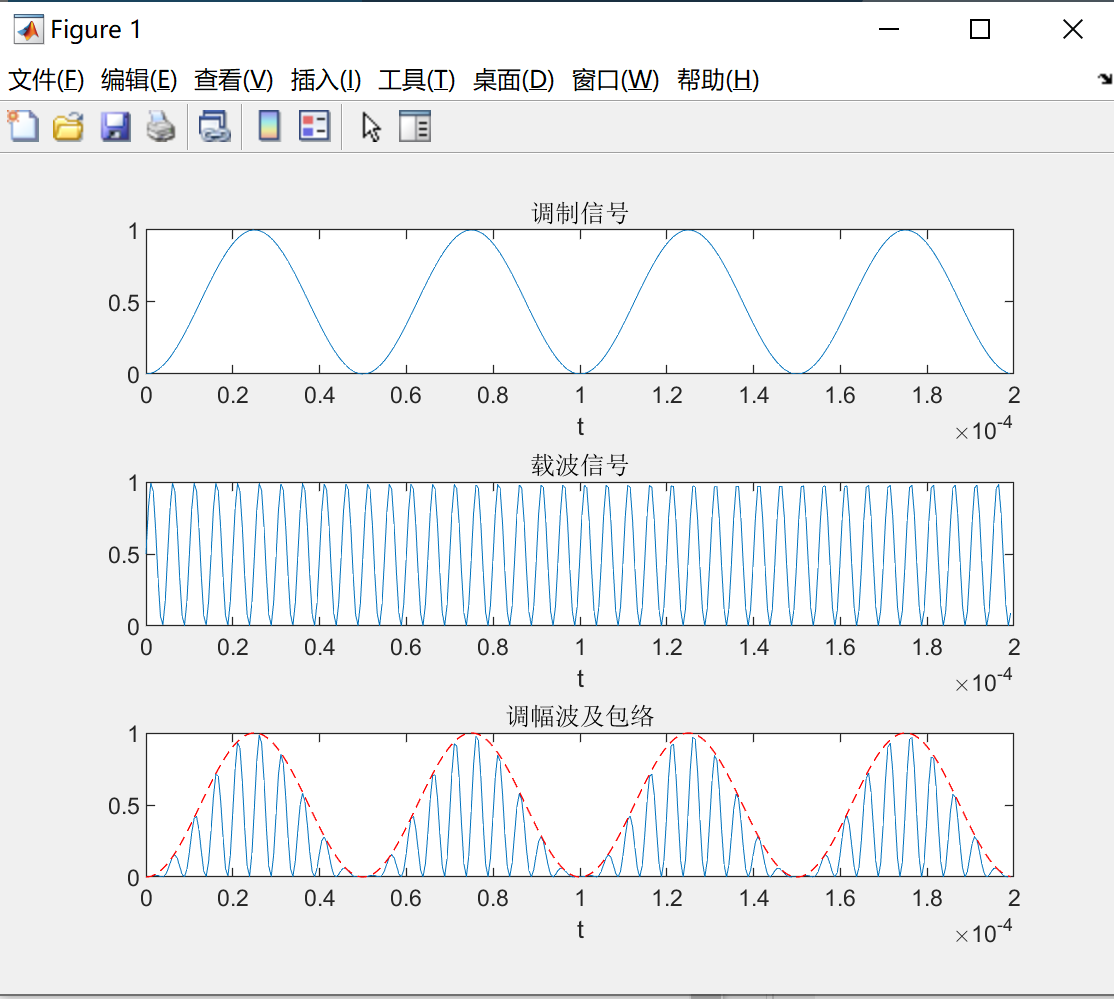
技术报告/调制0-1v仿真.png
