Emiyasama/200kHz-/技术报告/采样与包络计算仿真.jpg

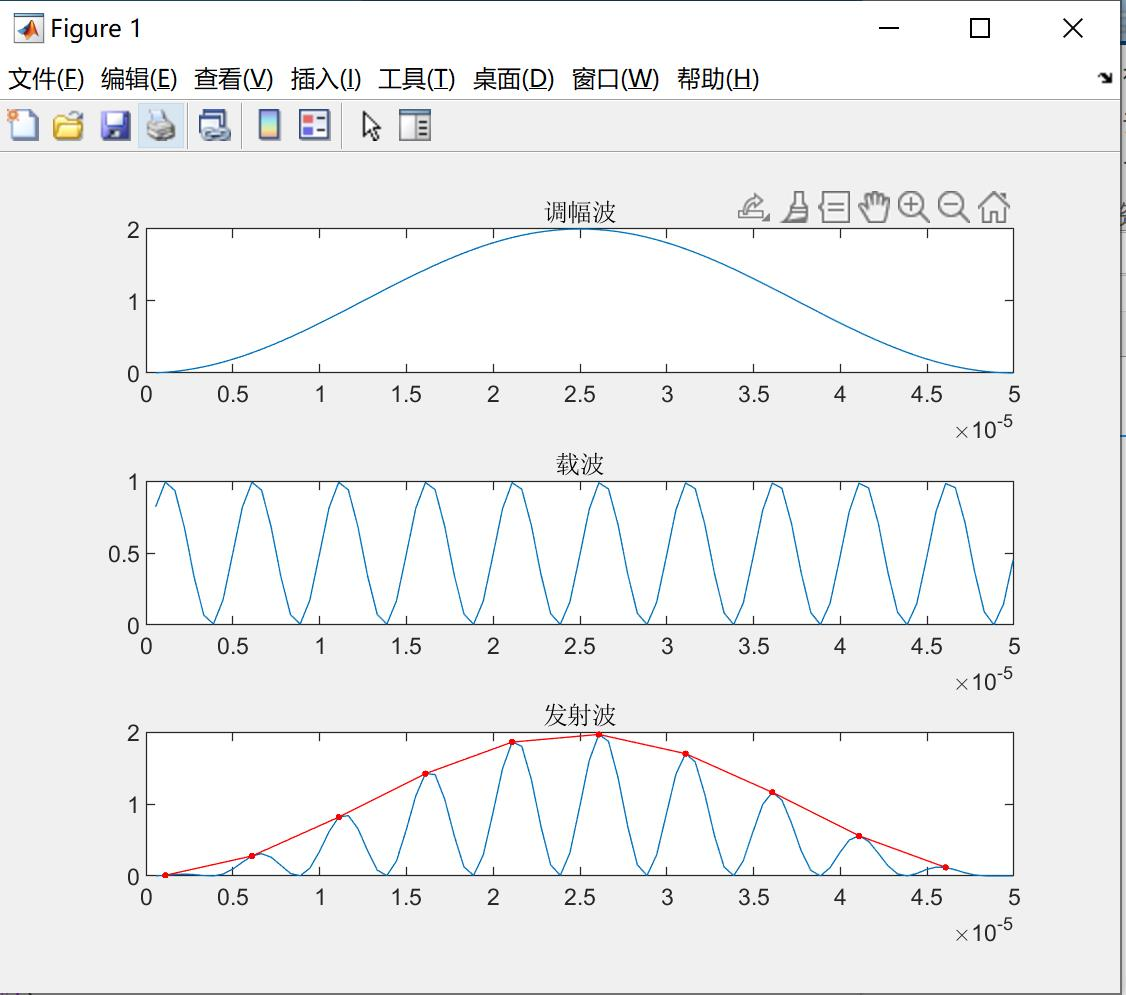
技术报告/采样与包络计算仿真.jpg
