Emiyasama/200kHz-/数据手册/STM32F103xx的接口定义V1.3.png

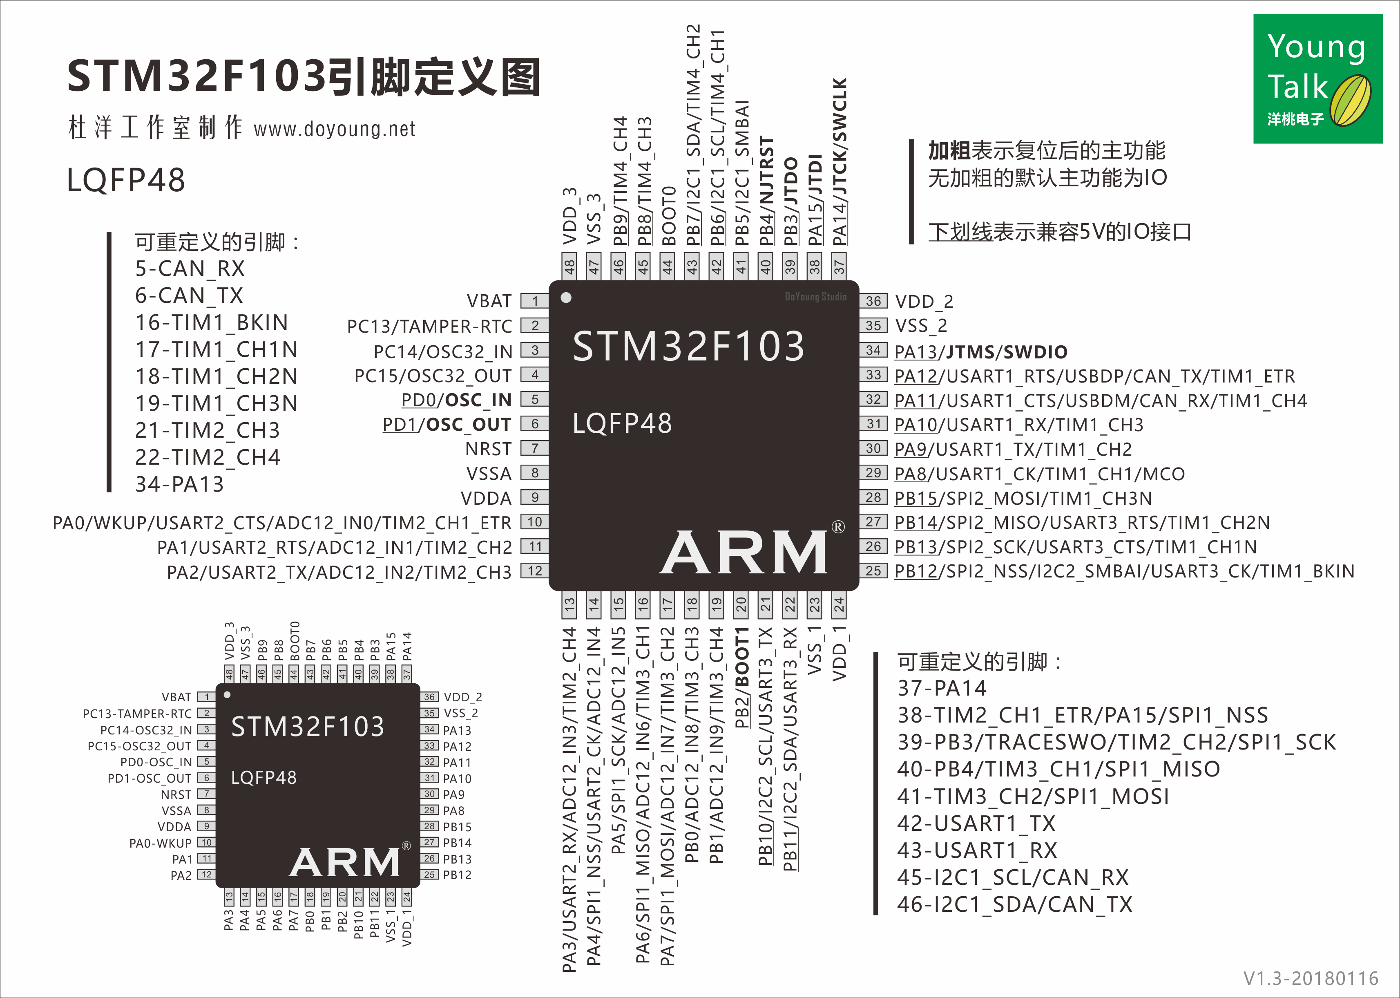
数据手册/STM32F103xx的接口定义V1.3.png
