Emiyasama/200kHz-/赛题要求/附件1：2022年广东省大学生电子设计竞赛队员名单汇总表（学校编号+学校名称+校区）.xlsx

Sheet: 报名表
附件1：2022年广东省大学生电子设计竞赛队员名单汇总表
学校： |  |  |  | 校区： |  |  | 学校地址：
竞赛负责人： |  |  |  | 负责人手机号： |  |  | 负责人QQ号: | 负责人邮箱:
竞赛领队： |  |  |  | 领队手机号： | 领队手机号： |  | 领队QQ号: | 领队邮箱:
序号 | 组别 | 学校编号 | 学校名称 | 校区 | 参赛队编号 | 参赛队员姓名 （排名第一为队长，必须3人成队） | 队员学号 | 队长联系 电话 | 作品名称 | 作品类型 | 作品主要功能简述（限50字以内）
1
2
3
4
5
6
7
8
9
10
学校主管竞赛负责人签名：
学校教务处盖章
说明（打印时不要打印本说明内容）： |  |  |  | 由所在学校统一向赛区竞赛组委会报名，不接受学生自行报名。
1 | 本表格行数不够时可自行添加。标黄项先填，相关单元格可自动显示，不用重复填。
2 | 同一个学校有多个校区的，一个校区交一个表格文件。
 | 报名表文件命名格式：学校编号+学校名称+“-”+校区名称，例：133中山大学新华学院-东莞校区.xlsx
3 | 各学校（校区）需上报：至少1名负责人和1名领队，如超过1名，请在相应行下方插入行后复制编辑。
4 | “参赛队编号”是识别比赛队伍的唯一号码，由7位数字组成： |  |  |  |  | 以“0”开头的编号输入方法：先输入一个半角英文的单引号再输入以“0”开头的编号
 | 1～3位为“学校编号”，由赛区组委会分配（参考本表的第二页“学校编号参照表”，若学校名称有变化或者不在列表中，请联系组委会黄老师）；
 | 第4位为校区代码，只有一个校区参赛的学校，此位数为“0”，有多个校区参赛的学校，代码由赛区组委会分配（参考本表的第二页“学校编号参照表”，若无校区代码，请联系组委会黄老师）
 | 5～7位为“组/队编号”，由各参赛学校根据本校参赛队数按顺序编排，本科组数字编排范围（001-099），高职高专组数字编排范围（从100开始）。
5 | 1个参赛队必须由3名学生组成，作品测试当天，3名学生原则上均需到场。
6 | 2022年5月25日开始报名，2022年6月30日中午12点截止报名。预计2022年8月20-29日期间评审。
7 | 竞赛作品现场测评当天，领队签到时提交纸质版报名表给组委会；纸质版须在指定位置加盖学校教务处公章，无学校公章的、参赛成绩无效。
8 | 请竞赛负责人和领队加入电赛“沟通”QQ群：708485731，部分不挂网的通知及其他事宜均在群内发布；
 | 请各院校（校区）专门安排一位老师作为联系人全程负责报名表格的提交、缴费开票信息、测评时间安排的确认、奖状信息提交等所有表格相关事项；
 | 请各院校（校区）填写电赛“沟通”QQ群内的“各院校（校区）联系人”信息收集表，组委会根据收到的信息将各院校（校区）联系人加入电赛“表格”QQ群768485096。
9 | 报名表格填写咨询：黄老师17098891918

Sheet: 学校编号参照表
学校名称 | 学校编号 | 校区编号 | 学校名称有误/变更的，可在表里直接修改；表中没有编号的学校，可自行在表格最末行的下一空白行填写学校名称并续编号码
中山大学 | 001 | 1广州 2深圳 3珠海
华南理工大学 | 002 | 1五山 2国际
暨南大学 | 003 | 1番禺 2珠海
华南农业大学 | 004
南方医科大学 | 005
广州中医药大学 | 006
华南师范大学 | 007
广东工业大学 | 008
广东外语外贸大学 | 009
汕头大学 | 010
广东财经大学 | 011
广东医科大学 | 012
广东海洋大学 | 013
仲恺农业工程学院 | 014
广东药科大学 | 015
星海音乐学院 | 016
广州美术学院 | 017
广州体育学院 | 018
广东技术师范大学 | 019 | 1天河 2白云
岭南师范学院 | 020
韩山师范学院 | 021
广东石油化工学院 | 022
广东金融学院 | 023
广东警官学院 | 024
广东第二师范学院 | 025
广州交通大学 | 026
广州大学 | 027
广州医科大学 | 028
深圳大学 | 029
南方科技大学 | 030
韶关学院 | 031
嘉应学院 | 032
惠州学院 | 033
东莞理工学院 | 034
五邑大学 | 035
佛山科学技术学院 | 036
肇庆学院 | 037
广州民航职业技术学院 | 038
广东轻工职业技术学院 | 039
广东省外语艺术职业学院 | 040
广东机电职业技术学院 | 041
广东工贸职业技术学院 | 042
广东职业技术学院 | 043
广东建设职业技术学院 | 044
广东理工职业学院 | 045
广东科学技术职业学院 | 046
广东交通职业技术学院 | 047 | 1花都 2清远
广东水利电力职业技术学院 | 048
广东司法警官职业学院 | 049
广东行政职业学院 | 050
广东体育职业技术学院 | 051
广东文艺职业学院 | 052
广东食品药品职业学院 | 053
广东女子职业技术学院 | 054
广东松山职业技术学院 | 055
广东农工商职业技术学院 | 056
广东邮电职业技术学院 | 057
广东工程职业技术学院 | 058
广东科贸职业学院 | 059
广东环境保护工程职业学院 | 060
广东青年职业学院 | 061
广东舞蹈戏剧职业学院 | 062
广州番禺职业技术学院 | 063
广州体育职业技术学院 | 064
广州工程技术职业学院 | 065
广州铁路职业技术学院 | 066 | 1白云 2花都
广州城市职业学院 | 067
广州科技贸易职业学院 | 068
深圳职业技术学院 | 069
深圳信息职业技术学院 | 070
珠海城市职业技术学院 | 071
汕头职业技术学院 | 072
河源职业技术学院 | 073
惠州卫生职业技术学院 | 074
汕尾职业技术学院 | 075
中山火炬职业技术学院 | 076
中山职业技术学院 | 077
江门职业技术学院 | 078
佛山职业技术学院 | 079
阳江职业技术学院 | 080
茂名职业技术学院 | 081
肇庆医学高等专科学校 | 082
清远职业技术学院 | 083
揭阳职业技术学院 | 084
罗定职业技术学院 | 085
顺德职业技术学院 | 086
东莞职业技术学院 | 087
广东生态工程职业学院 | 088
惠州城市职业学院 | 089
广东培正学院 | 090
广东白云学院 | 091
广东科技学院 | 092
广州商学院 | 093
广东东软学院 | 094
广州工商学院 | 095
广东理工学院 | 096
民办南华工商学院 | 097
私立华联学院 | 098
潮汕职业技术学院 | 099
广东新安职业技术学院 | 100
广东岭南职业技术学院 | 101
广东亚视演艺职业学院 | 102
广州康大职业技术学院 | 103
珠海艺术职业学院 | 104
广州涉外经济职业技术学院 | 105
广州南洋理工职业学院 | 106
广州科技职业技术学院 | 107
惠州经济职业技术学院 | 108
广东工商职业技术大学 | 109
广州华南商贸职业学院 | 110
广州华立科技职业学院 | 111
广州现代信息工程职业技术学院 | 112
广州珠江职业技术学院 | 113
广州松田职业学院 | 114
广东文理职业学院 | 115
广州城建职业学院 | 116
广东南方职业学院 | 117
广州华商职业学院 | 118
广州华夏职业学院 | 119
广东创新科技职业学院 | 120
广州东华职业学院 | 121
广东信息工程职业学院 | 122
广东碧桂园职业学院 | 123
北京师范大学－香港浸会大学联合国际学院 | 124
香港中文大学（深圳） | 125
北京师范大学珠海分校 | 126
电子科技大学中山学院 | 127
北京理工大学珠海学院 | 128
珠海科技学院 | 129
广州华立学院 | 130
广州应用科技学院 | 131
东莞城市学院 | 132
广州新华学院 | 133
广州南方学院 | 134
广州城市理工学院 | 135
华南农业大学珠江学院 | 136
广东外语外贸大学南国商学院 | 137
广东财经大学华商学院 | 138
湛江科技学院 | 139
广州理工学院 | 140
广州大学华软软件学院 | 141
广东开放大学 | 142
广东新华教育学院 | 143
广东社会科学大学 | 144
广州市广播电视大学 | 145
深圳市广播电视大学 | 146
广州金桥管理干部学院 | 147
广东省国防工业职工大学 | 148
广州市公安管理干部学院 | 149
南海成人学院 | 150
汕头市业余大学 | 151
韶关市职工大学 | 152
湛江教育学院 | 153
哈尔滨工业大学（深圳） | 154
陆军特种作战学院（广州） | 155
深圳技术大学 | 156

Sheet: 作品分类
作品分类
智慧生活
智慧医疗
智慧出行
智能测量
环境类
通信类
汽车电子类
其他
