Emiyasama/200kHz-/AD9851-DDS完整版-程序+PDF/AD9851-DDS完整版-程序+PDF/DDS_9851_最终版.pdf

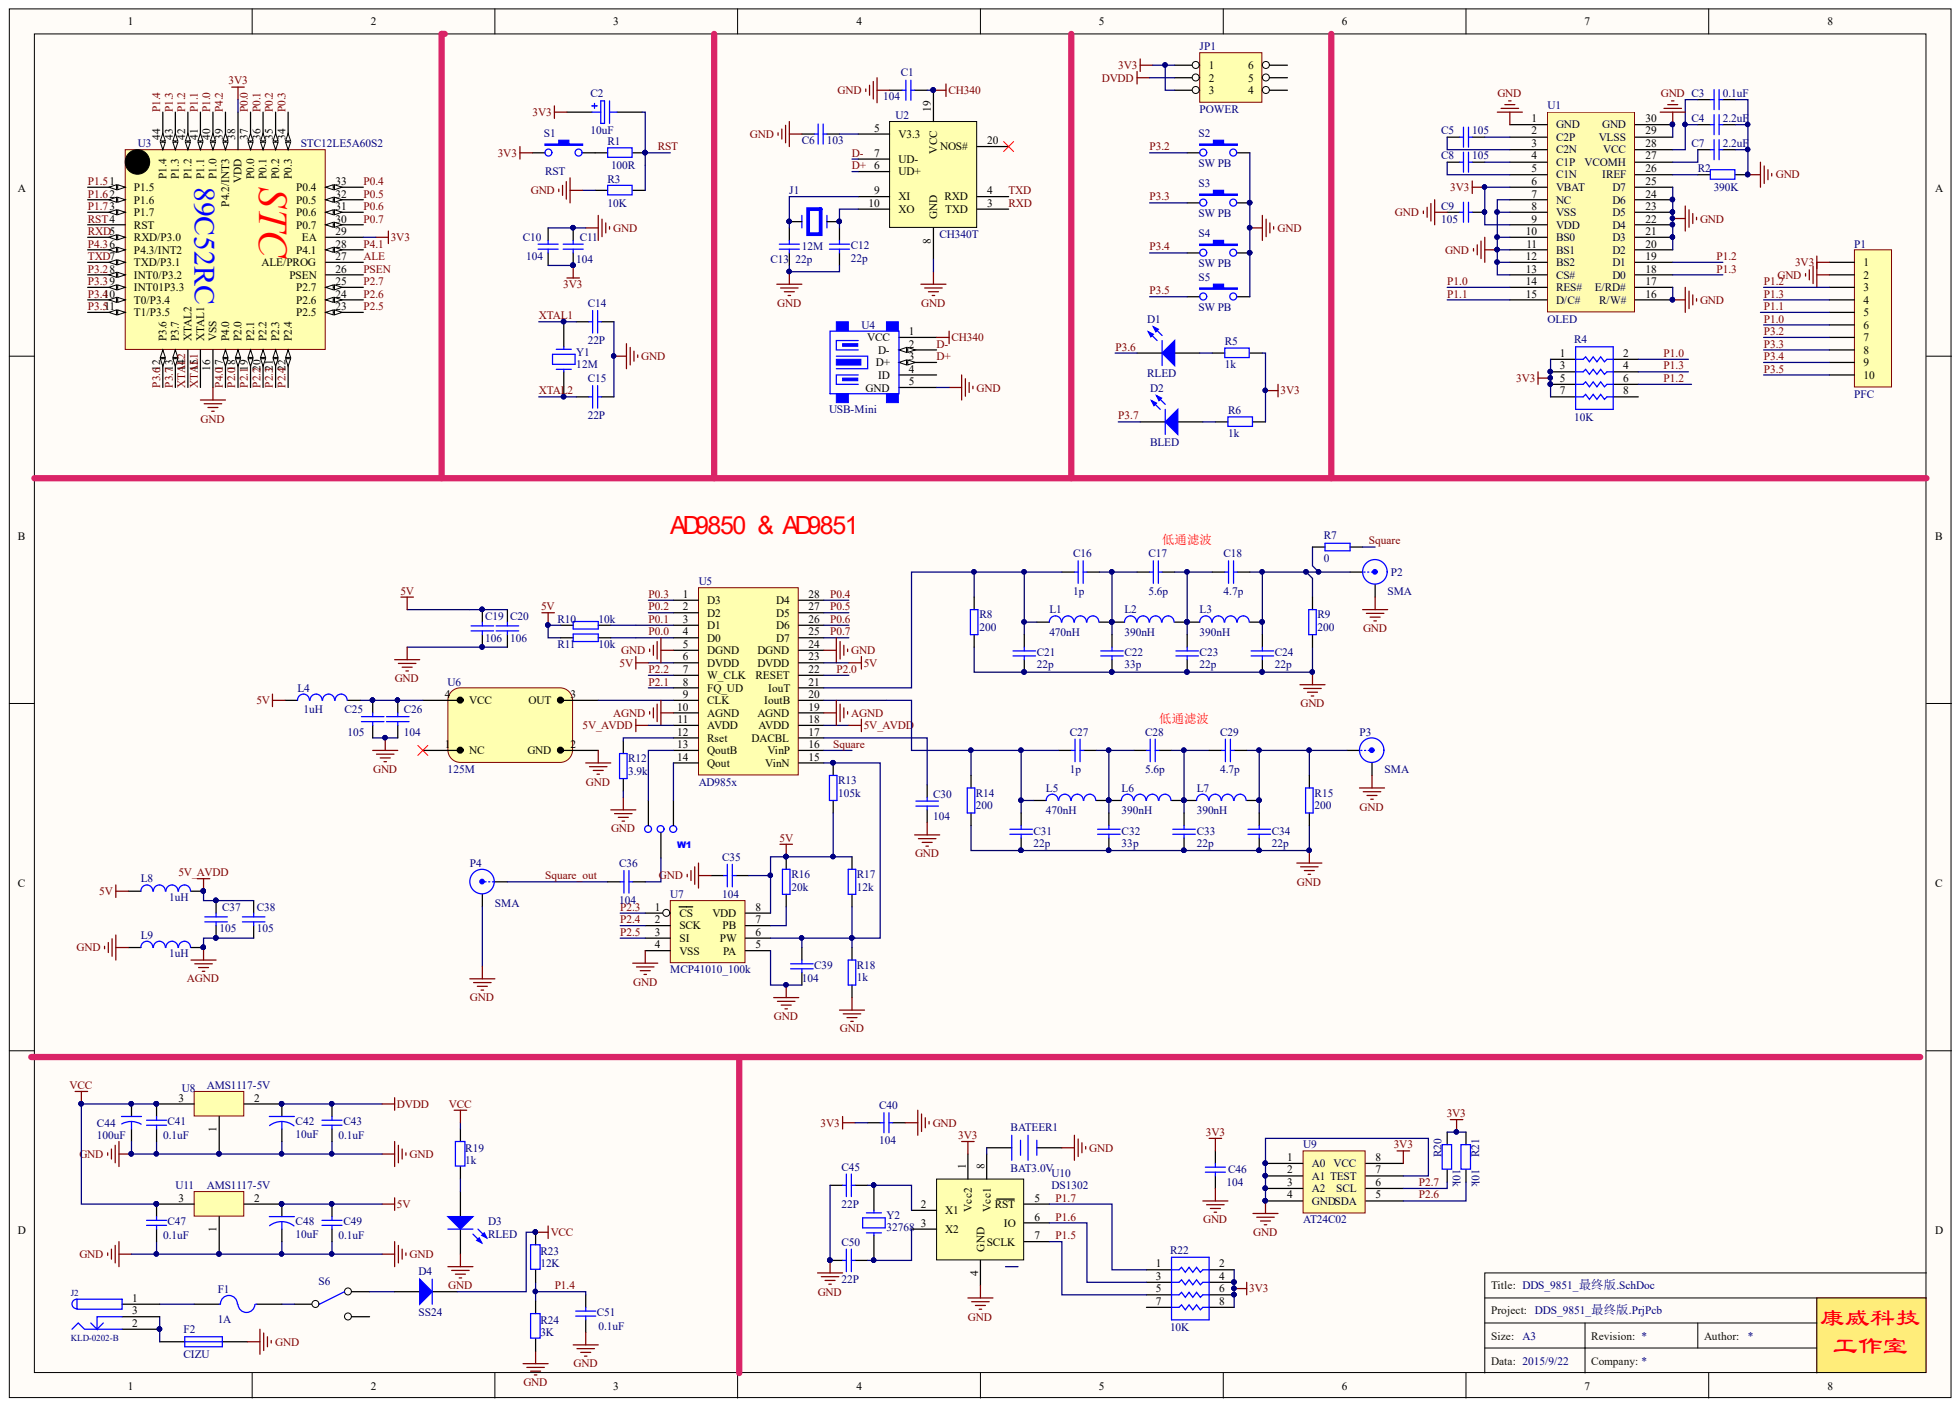
[picture p117: page 1]

P2.4 22 P2.5 23 P2.6 24 P2.7 25 PSEN 26 ALE/PROG 27 P4.1 28 EA 29 P0.7 30 P0.6 31 P0.5 32 P0.4 33 P0.3 34 P0.2 35 P0.1 36 P0.0 37 VDD 38 P4.2/INT3 39 P1.0 40 P1.1 41 P1.2 42 P1.3 43 P1.4 44

GND 4 | P2.6

Size: A3 | Revision: * | Author: *

Data: 2015/9/22 | Company: *
