Emiyasama/200kHz-/参考文献/【安富莱】D077-5_DAC8563 DAC模块_原理图.pdf

# 【安富莱】DAC8563_DAC模块原理图

D077-5

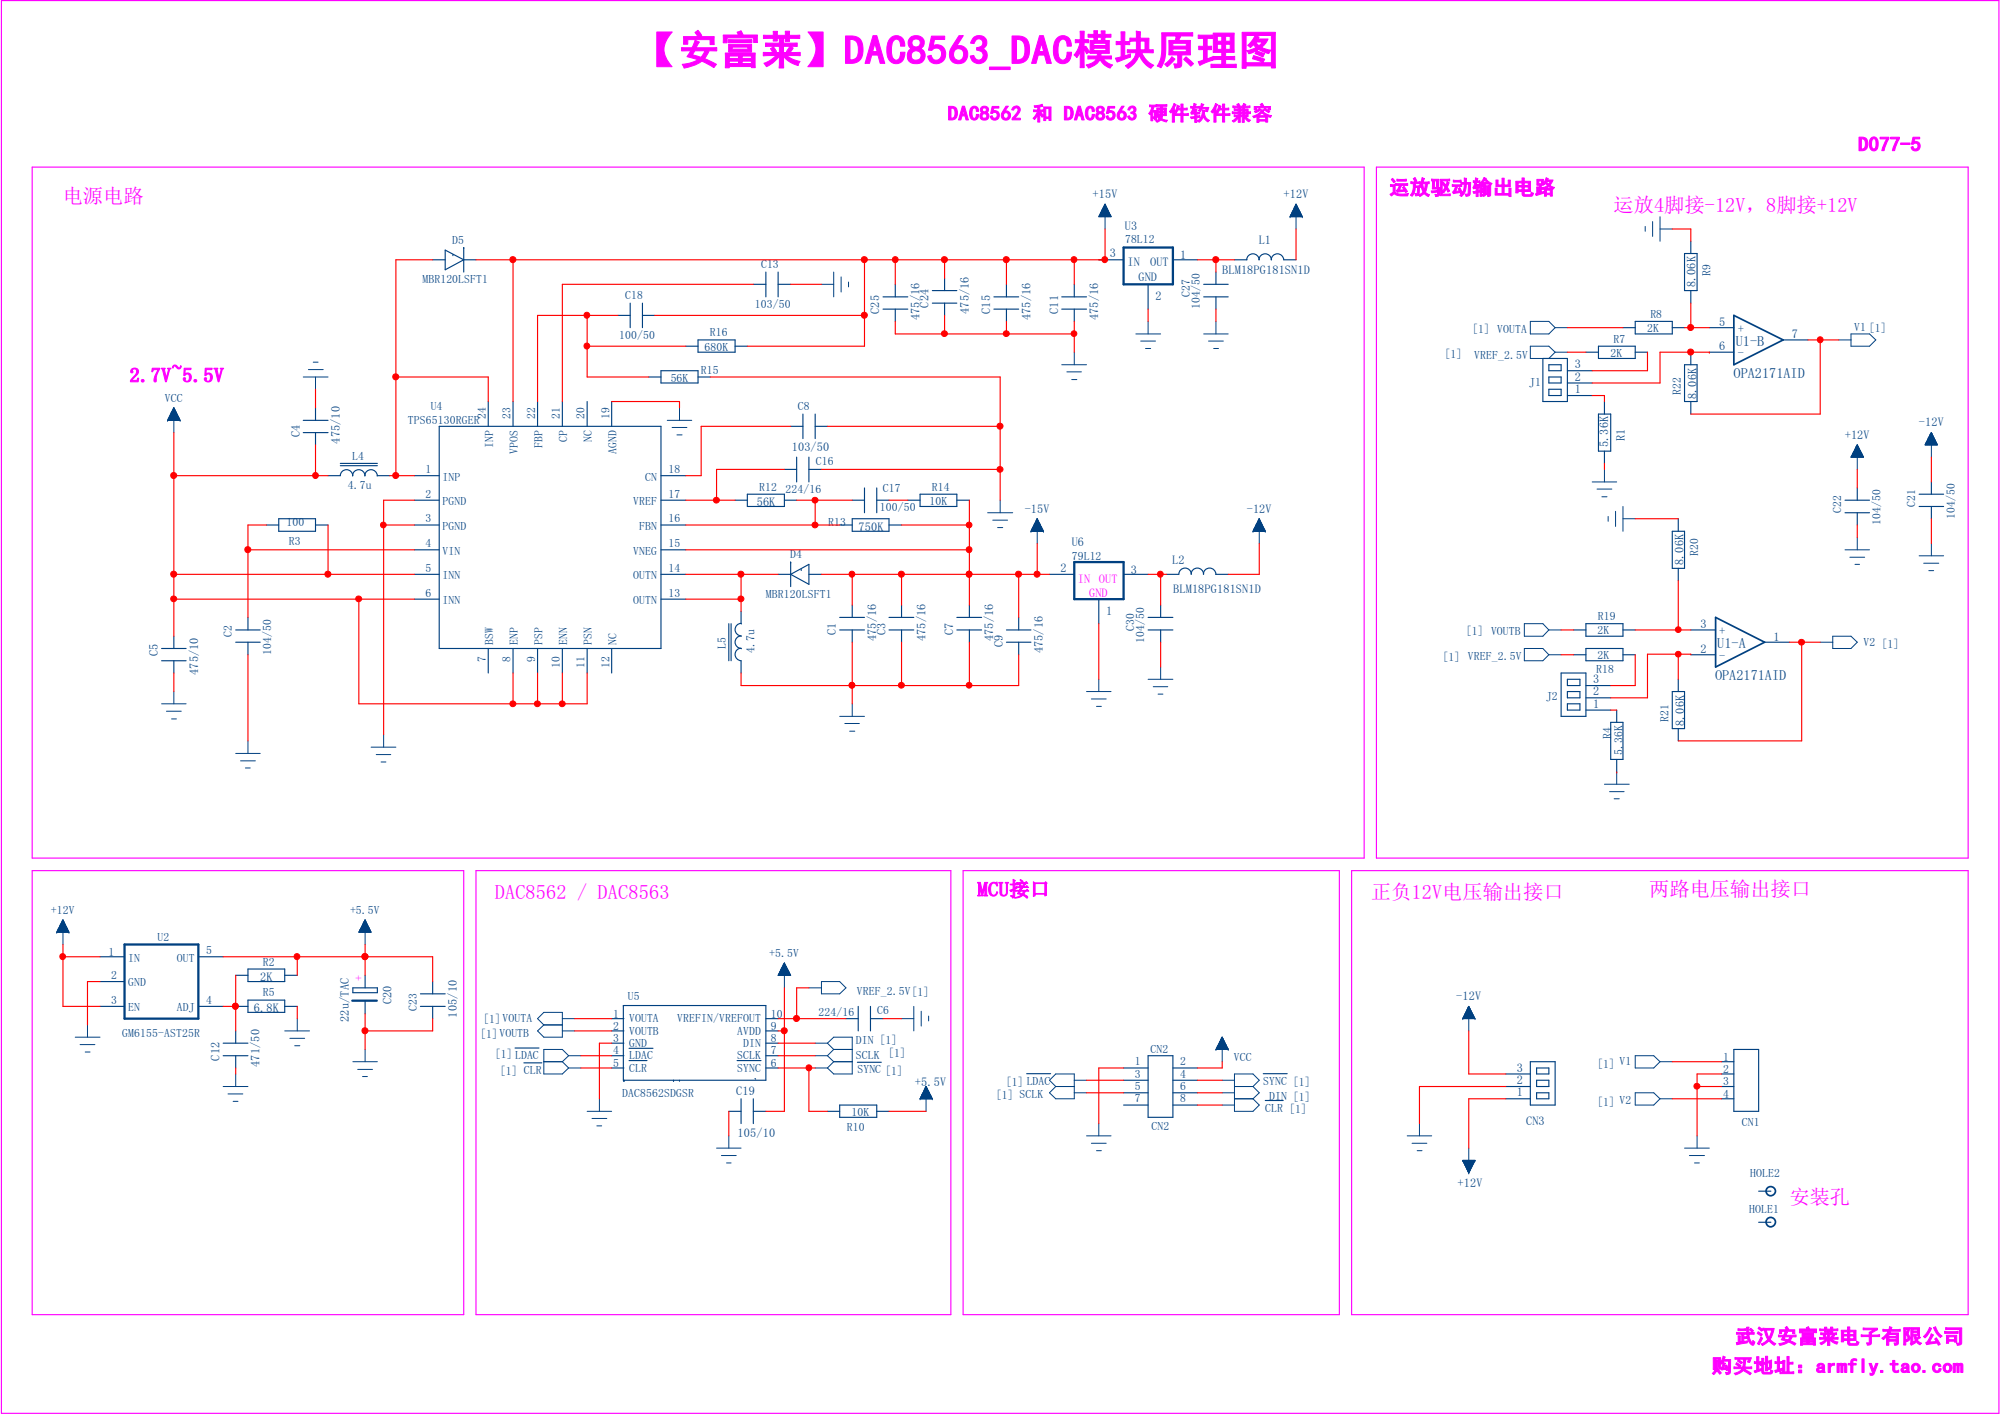
[picture p118: page 1]

武汉安富莱电子有限公司
购买地址：armfly.tao.com
