Emiyasama/200kHz-/(list of files, drawings)

Other design files:
仿真/电路仿真.ms14
完善部分/TDA2030功放.ms14
完善部分/超声波测距验证.pdsprj
