Emiyasama/200kHz-/1输入捕获高电平超声波测距代码_未测试/Basic/tim/tim.c

/*
《修改日志》
1- 创建。
2- 配置TIM3为计时器,TIM2为输入捕获器
3- 配置TIM5为输入捕获器，捕获高电平时间
*/

//#include "led.h" //因在中断处理函数中用到LED驱动

#include "tim.h"
#include "usart.h"

//定时器时间计算公式Tout = ((重装载值+1)*(预分频系数+1))/时钟频率;
//例如：1秒定时，重装载值=9999，预分频系数=7199


//定时器5通道1输入捕获配置
 
//定时器 2 通道 1 输入捕获配置
TIM_ICInitTypeDef TIM2_ICInitStructure;

void TIM2_Cap_Init(u16 arr,u16 psc)
{ 
		GPIO_InitTypeDef GPIO_InitStructure;
		TIM_TimeBaseInitTypeDef TIM_TimeBaseStructure;
		NVIC_InitTypeDef NVIC_InitStructure;
	
		RCC_APB1PeriphClockCmd(RCC_APB1Periph_TIM2, ENABLE); //使能 TIM2 时钟
		RCC_APB2PeriphClockCmd(RCC_APB2Periph_GPIOA, ENABLE); //使能 GPIOA 时钟
		
		GPIO_InitStructure.GPIO_Pin = getPin; //PA0 清除之前设置
		GPIO_InitStructure.GPIO_Mode = GPIO_Mode_IPD; //PA0 输入
		GPIO_Init(GPIOA, &GPIO_InitStructure);
		GPIO_ResetBits(getPORT,getPin);  //PA0 下拉
	
		//初始化定时器 2 TIM2
		TIM_TimeBaseStructure.TIM_Period = arr; //设定计数器自动重装值
		TIM_TimeBaseStructure.TIM_Prescaler =psc; //预分频器
		TIM_TimeBaseStructure.TIM_ClockDivision = TIM_CKD_DIV1; //设置时钟分割
		TIM_TimeBaseStructure.TIM_CounterMode = TIM_CounterMode_Up; //向上计数
		TIM_TimeBaseInit(TIM2, &TIM_TimeBaseStructure); //初始化 TIMx 的时间基数单位
	
		//初始化 TIM2 输入捕获参数
		TIM2_ICInitStructure.TIM_Channel = TIM_Channel_1; //选择输入端 IC1 映射到 TI1 上
		TIM2_ICInitStructure.TIM_ICPolarity = TIM_ICPolarity_Rising;  //上升沿捕获
		TIM2_ICInitStructure.TIM_ICSelection = TIM_ICSelection_DirectTI; //映射到 TI1 上
		TIM2_ICInitStructure.TIM_ICPrescaler = TIM_ICPSC_DIV1; //配置输入分频,不分频
		TIM2_ICInitStructure.TIM_ICFilter = 0x00;//IC1F=0000 配置输入滤波器 不滤波
		TIM_ICInit(TIM2, &TIM2_ICInitStructure);
		
		//中断分组初始化
		NVIC_InitStructure.NVIC_IRQChannel = TIM2_IRQn; //TIM2 中断
		NVIC_InitStructure.NVIC_IRQChannelPreemptionPriority = 2; //先占优先级 2 级
		NVIC_InitStructure.NVIC_IRQChannelSubPriority = 0; //从优先级 0 级
		NVIC_InitStructure.NVIC_IRQChannelCmd = ENABLE; //IRQ 通道被使能
		NVIC_Init(&NVIC_InitStructure); //初始化外设 NVIC 寄存器
		
		TIM_ITConfig(TIM2,TIM_IT_Update|TIM_IT_CC1,ENABLE);
		//允许更新中断 CC1IE 捕获中断
		TIM_Cmd(TIM2,ENABLE); //使能定时器 2
}


u8 TIM2CH1_CAPTURE_STA=0;  //输入捕获状态 
u16 TIM2CH1_CAPTURE_VAL; //输入捕获值

//定时器 5 中断服务程序 
void TIM2_IRQHandler(void)
{
		if((TIM2CH1_CAPTURE_STA&0X80)==0)//还未成功捕获 
		{ 
				if (TIM_GetITStatus(TIM2, TIM_IT_Update) != RESET)
				{ 
						if(TIM2CH1_CAPTURE_STA&0X40)//已经捕获到高电平了
						{
								if((TIM2CH1_CAPTURE_STA&0X3F)==0X3F)//高电平太长了
								{
											TIM2CH1_CAPTURE_STA|=0X80;//标记成功捕获了一次
											TIM2CH1_CAPTURE_VAL=0XFFFF;
								}else TIM2CH1_CAPTURE_STA++;
						} 
				}
				if (TIM_GetITStatus(TIM2, TIM_IT_CC1) != RESET)//捕获 1 发生捕获事件
				{ 
						if(TIM2CH1_CAPTURE_STA&0X40) //捕获到一个下降沿
						{ 
								TIM2CH1_CAPTURE_STA|=0X80;  //标记成功捕获到一次上升沿
								TIM2CH1_CAPTURE_VAL=TIM_GetCapture1(TIM2);
								TIM_OC1PolarityConfig(TIM2,TIM_ICPolarity_Rising);
								//CC1P=0 设置为上升沿捕获
						}else //还未开始,第一次捕获上升沿
						{
								TIM2CH1_CAPTURE_STA=0;  //清空
								TIM2CH1_CAPTURE_VAL=0;
								TIM_SetCounter(TIM2,0);
								TIM2CH1_CAPTURE_STA|=0X40;  //标记捕获到了上升沿
								TIM_OC1PolarityConfig(TIM2,TIM_ICPolarity_Falling);
								//CC1P=1 设置为下降沿捕获
						} 
				}		 
		}
		TIM_ClearITPendingBit(TIM2, TIM_IT_CC1|TIM_IT_Update); //清除中断标志位
}





























//void TIM3_Init(u16 arr,u16 psc){  //TIM3 初始化 arr重装载值 psc预分频系数
//		TIM_TimeBaseInitTypeDef     TIM_TimeBaseInitStrue;
//    RCC_APB1PeriphClockCmd(RCC_APB1Periph_TIM3,ENABLE);//使能TIM3
//		//KEY_Init();//输入口按键初始化
//    TIM3_NVIC_Init (); //开启TIM3中断向量
//	      
//    TIM_TimeBaseInitStrue.TIM_Period=arr; //设置自动重装载值
//    TIM_TimeBaseInitStrue.TIM_Prescaler=psc; //预分频系数
//    TIM_TimeBaseInitStrue.TIM_CounterMode=TIM_CounterMode_Up; //计数器向上溢出
//    TIM_TimeBaseInitStrue.TIM_ClockDivision=TIM_CKD_DIV1; //时钟的分频因子，起到了一点点的延时作用，一般设为TIM_CKD_DIV1
//    TIM_TimeBaseInit(TIM3,&TIM_TimeBaseInitStrue); //TIM3初始化设置
//    TIM_ITConfig(TIM3, TIM_IT_Update, ENABLE);//使能TIM3中断    
//    TIM_Cmd(TIM3,DISABLE); //使能TIM3
//}

//void TIM2_Init(u16 arr,u16 psc){
//		TIM_ICInitTypeDef TIM2_ICInitStructure;
//		GPIO_InitTypeDef GPIO_InitStructure;
//		TIM_TimeBaseInitTypeDef TIM_TimeBaseStructure;
//	
//		RCC_APB1PeriphClockCmd(RCC_APB1Periph_TIM2, ENABLE); //使能 TIM2 时钟
//		RCC_APB2PeriphClockCmd(RCC_APB2Periph_GPIOA, ENABLE); //使能 GPIOA 时钟
//		TIM2_NVIC_Init (); //开启TIM2中断向量
//	
//		GPIO_InitStructure.GPIO_Pin = getPin; //PA0(getPin) 清除之前设置
//		GPIO_InitStructure.GPIO_Mode = GPIO_Mode_IPD; //PA0 输入
//		GPIO_Init(getPORT, &GPIO_InitStructure);
//		GPIO_ResetBits(getPORT,getPin); //PA0(getPin) 下拉

//		//初始化定时器 2 TIM2
//		TIM_TimeBaseStructure.TIM_Period = arr; //设定计数器自动重装值
//		TIM_TimeBaseStructure.TIM_Prescaler =psc; //预分频器
//		TIM_TimeBaseStructure.TIM_ClockDivision = TIM_CKD_DIV1; //设置时钟分割
//		TIM_TimeBaseStructure.TIM_CounterMode = TIM_CounterMode_Up; //向上计数
//		TIM_TimeBaseInit(TIM2, &TIM_TimeBaseStructure); //初始化 TIMx 的时间基数单位

//		//初始化 TIM2 输入捕获参数
//		TIM2_ICInitStructure.TIM_Channel = TIM_Channel_1; //选择输入端 IC1 映射到 TI1 上
//		TIM2_ICInitStructure.TIM_ICPolarity = TIM_ICPolarity_Rising; //上升沿捕获
//		TIM2_ICInitStructure.TIM_ICSelection = TIM_ICSelection_DirectTI; //映射到 TI1 上
//		TIM2_ICInitStructure.TIM_ICPrescaler = TIM_ICPSC_DIV1; //配置输入分频,不分频
//		TIM2_ICInitStructure.TIM_ICFilter = 0x00;//IC1F=0000 配置输入滤波器 不滤波
//		TIM_ICInit(TIM2, &TIM2_ICInitStructure);

//		TIM_ITConfig(TIM2, TIM_IT_CC1, ENABLE);//使能TIM2中断   
//		TIM_Cmd(TIM2,DISABLE); //使能TIM2
//}


//void TIM3_NVIC_Init (void){ //开启TIM3中断向量
//	NVIC_InitTypeDef NVIC_InitStructure;
//	NVIC_InitStructure.NVIC_IRQChannel = TIM3_IRQn;	
//	NVIC_InitStructure.NVIC_IRQChannelPreemptionPriority = 0x3;	//设置抢占和子优先级
//	NVIC_InitStructure.NVIC_IRQChannelSubPriority = 0x3;
//	NVIC_InitStructure.NVIC_IRQChannelCmd = ENABLE;
//	NVIC_Init(&NVIC_InitStructure);
//}

//void TIM2_NVIC_Init (void){ //开启TIM3中断向量
//	NVIC_InitTypeDef NVIC_InitStructure;
//	NVIC_InitStructure.NVIC_IRQChannel = TIM2_IRQn;	
//	NVIC_InitStructure.NVIC_IRQChannelPreemptionPriority = 0x2;	//设置抢占和子优先级
//	NVIC_InitStructure.NVIC_IRQChannelSubPriority = 0;
//	NVIC_InitStructure.NVIC_IRQChannelCmd = ENABLE;
//	NVIC_Init(&NVIC_InitStructure);
//}

//u16 t;
//u8 Capture_State=1;
//void TIM3_IRQHandler(void){ //TIM3中断处理函数
//    if (TIM_GetITStatus(TIM3, TIM_IT_Update) != RESET){	//判断是否是TIM3中断
//        TIM_ClearITPendingBit(TIM3, TIM_IT_Update);
//        //此处写入用户自己的处理程序
//				t++;
//				//Capture_State = GPIO_ReadInputDataBit(KEYPORT,KEY1); //判断PA6输入引脚值,初始化后应一直保持为0
//			
//    }
//}

//float time_us;
//float times;
//void TIM2_IRQHandler(void){
//		if (TIM_GetITStatus(TIM2, TIM_IT_CC1) != RESET)//捕获 1 发生捕获事件
//		{
//				time_us=TIM_GetCounter (TIM2);
//				times=t*100+time_us;//times单位为us
//			  Capture_State=1;  //为1后停止计时
//		}
////		if(GPIO_ReadInputDataBit(getPORT,getPin)==0){
////				Capture_State=0;   //接收端电压为0了
////		}

//}
