Emiyasama/200kHz-/AD9851-DDS完整版-程序+PDF/AD9851-DDS完整版-程序+PDF/STC——AD9851DDS完整版/source/MCP41xx.c

/**********************************************************
                       康威科技
更多电子需求，请到淘宝店，康威电子竭诚为您服务 ^_^
https://kvdz.taobao.com/
**********************************************************/

#include "MCP41xx.h"
#include "STC12C5A60S2.H"


void mcp_delay(uint n)
{
	n=n*110;
	while(n--);
}

void MCP41xx_writedata(uchar dat1)		//调整数字电位器
{
	
  uchar i,command=0x11;
	
	MCP41xx_SPI_CS_H();//cs=1; 
	MCP41xx_SPI_CLK_L();//sck=1;
	MCP41xx_SPI_CS_L();//cs=0;

 	 mcp_delay(10);

	for(i=0;i<8;i++)          //写命令
	{ 
		if(command & 0x80)
		{
			MCP41xx_SPI_DAT_H();//si=1;	
		}
		else
		{
			MCP41xx_SPI_DAT_L();//si=0;
		}
		mcp_delay(10);
		MCP41xx_SPI_CLK_L();//sck=1;//sck=1;
		mcp_delay(10);
		MCP41xx_SPI_CLK_H();//sck=0;sck=0;
		mcp_delay(10); 

		command=command<<1;
	}

     
	for(i=0;i<8;i++)          //写数据
	{ 
		
		if(dat1 & 0x80)
		{
			MCP41xx_SPI_DAT_H();//si=1;	
		}
		else
		{
			MCP41xx_SPI_DAT_L();//si=0;
		}
		mcp_delay(10);
		MCP41xx_SPI_CLK_L();//sck=1;//sck=1;
		mcp_delay(10);
		MCP41xx_SPI_CLK_H();//sck=0;sck=0;
		mcp_delay(10);
		dat1=dat1<<1;
	}

	MCP41xx_SPI_CS_H();//cs=1; //cs=1;

	mcp_delay(10);//_nop_();
}
