Emiyasama/200kHz-/(commit log)

2022-11-07 上传了超声波测距代码
    [ADC采集数据.xlsx, TDA2030功放.ms14, 电路仿真.ms14, 相位计算数据.xlsx, 超声波测距验证.pdsprj, 附件1：2022年广东省大学生电子设计竞赛队员名单汇总表（学校编号+学校名称+校区）.xlsx]
2022-11-07 修改了readme.md
2022-11-07 修改了双定时器程序
2022-11-22 11月22更新方案
    [ADC采集数据.xlsx]
